jmfriedt/sensor/doc/allocation_regs_modbus.pdf

100+(NB_PICS_MAX*ANTENNES_MAX*2) | A0
..+(NB_PICS_MAX*ANTENNES_MAX*4)
..+(NB_PICS_MAX*ANTENNES_MAX*6) | A2 A1
1000..1000+(NB_PICS_MAX*ANTENNES_MAX*2) | frequences

deviendra *1 quand on stockera temperatures

*2 tant qu’on stocke frequences
