jmfriedt/sensor/doc/interrogateur.pdf

## Algorithme du firmware

C. Droit, 10 mai 2010

## 1 Introduction

Voici un aper¸cu de l’algorithme du firmware

## 2 Explication de la fonction main (Fig. 1)

Le menu pricipal “main” est le corp du programme, il va de l’initialisation `a l’affichage des donn´ees en passant par l’appel des fonctions.
– M1 → Calcul du pas de fr´equence en fonction de Fintsta et Fintsto (Fig. 3)
– M2 → L’interrogation est s´epar´ee en deux parties, une interrogation des capteurs de pression puis des capteurs de temp´erature (interrogation + affichage des donn´ees). Pour avoir un affichage valide de la fr´equence de r´esonance, l’interrogateur doit voir soit tous les capteurs de pression ou tous les capteurs de temp´erature. Dans le cas ou nous activons le mode tracking, si l’interrogateur ne voit plus un capteur de pression, il passe en interrogation peigne fixe sans perturber le mode tracking sur les capteurs de temp´erature.

## 3 Explication fonction balaie ism (Fig. 2)

La fonction balaie ism est la fonction permettant l’interrogation, elle va g´erer l’´emission de fr´equence, la r´eception et le traitement de la mesure, et le calcule de la fr´equence de r´esonance. – B1 → En fonction du mode activ´e mode “tracking” ou “peigne fixe” avec la variable “mode balaye continu”, l’ex´ecution du programme passe par la localisation de la fr´equence de r´esonance une premi´ere foi pour pouvoir calculer la nouvelle fenˆetre d’interrogation qui sera utilis´ee lors du prochain passage dans la fonction. Soit le mode tracking est activ´e et l’ex´ecution passe pas B1 ou nous allons directement `a la partie B5.
– B2 → La boucle de r´ep´etition permet l’accumulation de NBMOY mesure pour calculer la variance et la moyenne des fr´equences de r´esonances trouv´ees.
– B3 → Le traitement de la mesure permet avoir la moyenne des fr´equences de r´esonances trouv´ees et la variance sur ces fr´equences, ce qui permet de juger si la mesure r´ealis´ee est bonne ou fausse.
– B4 → Nous retournons 100 + total si nous avons r´eussi `a avoir NBMOY mesure, la variable “total“ est le nombre d’interrogation effectu´ee. Sinon, nous retournons BSP (le nombre mesure acquise et valide).
– B5 → Si nous avons choisi le mode peigne fixe, nous arrivons directement dans cette partie de la fonction. Sinon si le mode tracking est choisi, nous avons d´eja ´effectu´e le premier balayage qui nous a permit d’ajuster la fenˆetre d’interrogation.
– B6 → En mode tracking, si nous ne trouvons pas la fr´equence de r´esonance dans les points acquis, nous agrandissons la fenˆetre d’interrogation tant que nous n’avons pas la fr´equence de r´esonance. Nous avons ajout´e un d´elai avant de l’agrandir pour ´eviter de sortir trop vite du mode tracking. La fenˆetre d’interrogation ne peut ˆetre plus grande que les fr´equences limites que nous avons rentr´e (Finsta, Finsto). Dans le cas ou nous ne trouvons pas de fr´equence de r´esonance, nous retournons que nous avons pas trouv´e de fr´equence de r´esonance (bsp=0) et une variance de 100000 + le num´ero du r´esonateur l’interrogateur n’a pas trouv´e. Avec une grande variance, nous pouvons ´eliminer la mesure quand nous l’afficherons dans l’interface graphique.

Main

Asservissement de puissance (contrôle de gain)

Initialisation du système DDS + Aduc

Pour chaque antenne

Gestion de la communication +++

Pour tous les capteurs Pression//température

(M1)

(M2)

Appèle de la fonction Balaie_ism

Calcule du pas de fréquence/ Fstart/ Fstop

Balayage_primaire=1;

Activation ou désactivation du mode tracking En fonction de mode_balayage_continu Balayage_primaire=(0/1)

Si la fréquence de résonance trouvée est stable (critère de
Variance), on passe / reste en mode tracking

Ajustement de la fenêtre d'interrogation

Fstart=fréquence de résonance – 1*freq de step Fstop=fréquence de résonance + 1*freq de step

Mode tracking

Sinon on utilise l'ancienne valeur de fréquence Sauvegardée pour délimiter la fenêtre d'interrogation

En peigne fixe
Fstart=finsta du résonateur Fstop=finstop du résonateur

Enregistrement de la fréquence

Affichage des données

Si les critères de seuil sont respectés <Seuil_max
>Seuil_min

Affichage des données

Rs232->
Fréquence/Amplitude/Puissance/Variance

Rs232->
00000000/Amplitude/Puissance/Variance

Pour chaque antenne

Affichage de BSP

Fin

Répétition tant que nb relevé < NB_REPETITION

Figure 1 – Menu principal

Balaie_ism

Mode tracking activé (Balayage primaire==0 && mode_balayage_continu==0)

Scanne de toute la bande ISM

Interrogation de Fstart à Fstop

Emission fréquence par fréquence à une puissance définit pendant Un temps (EMET)

Commutation Emission/Reception

Sauvegarde dans Tab0 des amplitudes reçues

Analyse des données acquises

Recherche des sommets Max

Condition: amplitude
>Seuil_min et <Seuil_max

Calcul de la fréquence de résonance

Fit parabolique: Parab[]=
(Freqres[]+la correction du fit)

Incrémentation variable:
Bsptmp, si pic trouvé
Total: Nb interrogation effectuée

Boucle de répétition tant que Nb résonance Trouvée < NBMOY et le nombre d'inter-Rogation < NBMOY*NBRATE

Mode tracking activé ( premier balayage effectué) ou interrogation peigne fixe (Balayage primaire==1 || mode_balayage_continu==1)

Détection de fréquence de résonance

Si Bsp (nb fréquence de résonance acquise) =
NBMOY( nb fréquence voulu)

Retourne Total+100

Retourne Bsp

Calcul de la moyenne des fréquences de résonance
Calcul de variance des fréquences de résonance | Traitement
Sur la mesure

Retour vers le menu
principal

Scanne en mode 3 points || peigne fixe

Détection de fréquence de résonance

Fenêtre d'interrogation = 3 points par fréquence de résonance

Fréquence de résonance non détecté

Agrandissement de la fenêtre d'interrogation Coefficient de fenêtre incrémenté de 1

Délai d'interrogation de la fenêtre écoulé

On attend avant augmenter la fenêtre d'interrogation, cela permet de faire quelques essaies

Calcul de Fstart et Fstop

Boucle de répétition tant que Nb résonance Trouvées < NBMOY et le nombre d'inter-Rogation < NBMOY*NBRATE

Mode Tracking

Si la fenêtre d'interrogation dépasse
Fstart et Fstop peigne fixe, on rescanne
Toute la bande ISM (balayage_primaire=0)

Retroune bsp=0 et une variance de 100000 + le numéro du résonateur non trouvé

Mode Tracking

Traitement de la mesure

Retour vers mesure principale

Lo

c

alisation des fréquenc

es de résonanc

es m

ode tra

cking par peigne fix

e

M

o

d

e tra

cking

&

m

o

d

e

b

a

al ya

g

e

p

eigne fix

e

F

onction b

alaie

_ism

Les variables NBMOY et NBRATE
Sont configurable dans DDS.h elles correspondent au nombre de moyenne et d'itération à effectuer avant de quitter l'interrogation et d'afficher la valeur de la fréquence de résonance trouvée

(B1)

(B2)

(B4)

(B5)

(B6)

(B6) (B2)

(B3)

Figure 2 – Fonction Balaie ism

## 4 Taux de rafraˆıchissement

Interrogation de 2 r´esonateurs :
– Mode tracking, NBMOY=16 Taux de rafraˆıchissement max = 45 Hz – Mode tracking, NBMOY=1 Taux de rafraˆıchissement max = 90 Hz – Mode peigne fixe, NBMOY=16 Taux de rafraˆıchissement = 45 Hz – Mode peigne fixe, NBMOY=1 Taux de rafraˆıchissement = 5 Hz Interrogation de 3 r´esonateurs :
– Mode tracking, NBMOY=16 Taux de rafraˆıchissement max = 32 Hz – Mode peigne fixe, NBMOY=16 Taux de rafraˆıchissement = 3 Hz

## 5 Configuration du fichier DDS.h (Fig. 3)

Dans le fichier de configuration ”DDS.h“, nous pouvons configurer plusieurs param`etres : – L’offset : OFFSET 0xDDD0000
– Mode de debuggage qui permet de voir le d´eroulement du programme define debug
– Controle automatique de puissance agc=1 ;
– Nombre de moyenne NBMOY=16 ;
– Nombre de r´esonateur NBPICS=2 ;
– Nombre de pas par bande NBSTEPS=(64)
– Nombre d’antenne ANTENNES=1 ;
– Mode tacking/peigne fixe mode balayage continu=1 ;
– Nombre de r´esonateur d’une grandeur physique PRESSION
– Nombre de r´esonateur de l’autre grandeur physique TEMPERATURE
– Nombre de r ´ep´etition de la mesure de la premi´ere grandeur NB REPETITION
– Borne de fr´equence de start Fintsta[NBPICS MAX]=0x28F5C200, 0x2CCCCC00, 0x2E147AE0; – Borne de fr´equence de stop Fintsto[NBPICS MAX]=0x2CAC0800, 0x2E147AE0, 0x2F5C2800; Pour avoir un mesure valide, nous devons voir tous les capteurs de la grandeur PRESSION
ou tout les capteurs de la grandeur TEMPERATURE. La somme de (PRESSION + TEM-PERATURE)=( NB PIC MAX )=(NB PIC). Si nous avons un capteur de temperature constitu´e de 2 r´esonateurs avec un capteur de pression constitu´e d’un r´esonateur, on a PRES-SION = 1, TEMPERATURE = 2, NB PIC=3, NB PIC MAX =3.

## 6 D´ebuggage et affichage des donn´ees

Pour ´eliminer les fr´equences erron´ees, nous pouvons filtrer :
– Avec une hauteur Max/min d’amplitude d´etect´ee
– Avec une variance faible, si la variance est ´elev´ee, c’est que nous avons des perturbations. Si elle est de 100000, 100001... Nous n’avons pas r´eussi `a trouver le r´esonateur 1,2... en mode tracking.
– Le nombre BSP correspond au nombre de valeur trouv´ee si il est < `a NBMOY sinon il correspond au nombre d’interrogation total r´ealis´e quand nous avons r´eussi `a avoir NBMOY fr´equence de r´esonance.


Figure 3 – DDS.h
