jmfriedt/sensor/doc/131206timing_gillouxV1_HATTENTE.png

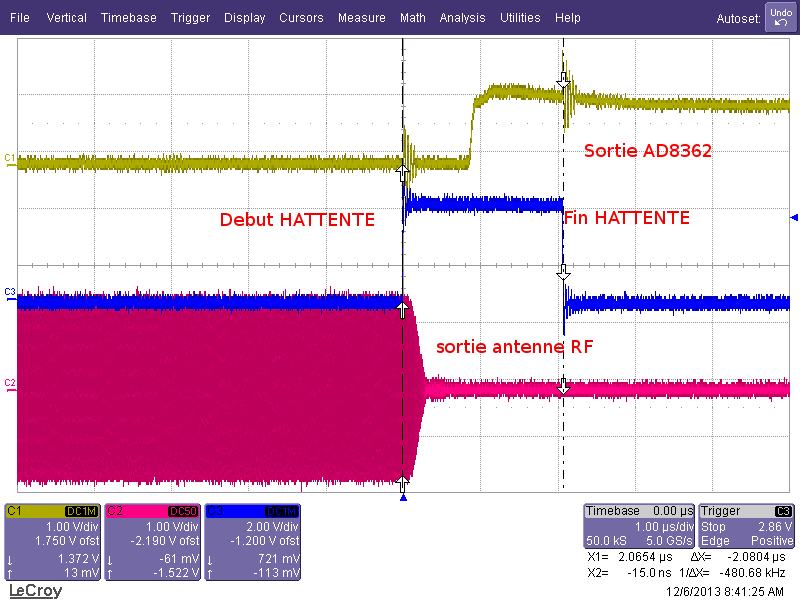
doc/131206timing_gillouxV1_HATTENTE.png
