jmfriedt/sensor/doc/131206timing_gillouxV1_HATTENTEx5.png

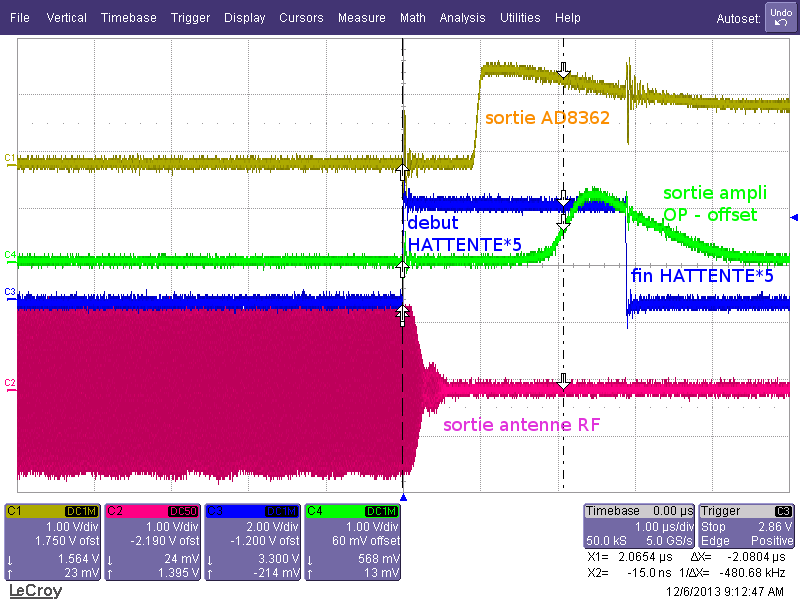
doc/131206timing_gillouxV1_HATTENTEx5.png
