jmfriedt/sensor/doc/AD8302_20dBmag.png

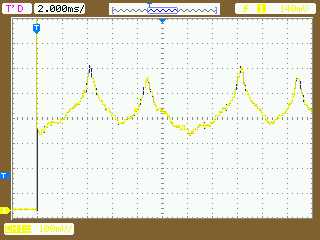
doc/AD8302_20dBmag.png
