jmfriedt/sensor/doc/AD8302_20dBpha.png

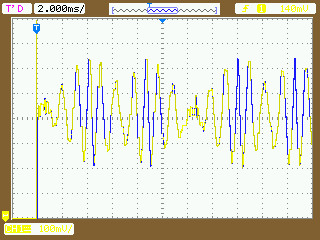
doc/AD8302_20dBpha.png
