jmfriedt/sensor/doc/AD8302_30dBmag.png

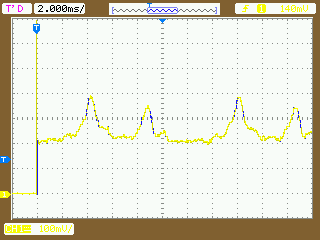
doc/AD8302_30dBmag.png
