jmfriedt/sensor/pictures/IMG_0642.JPG

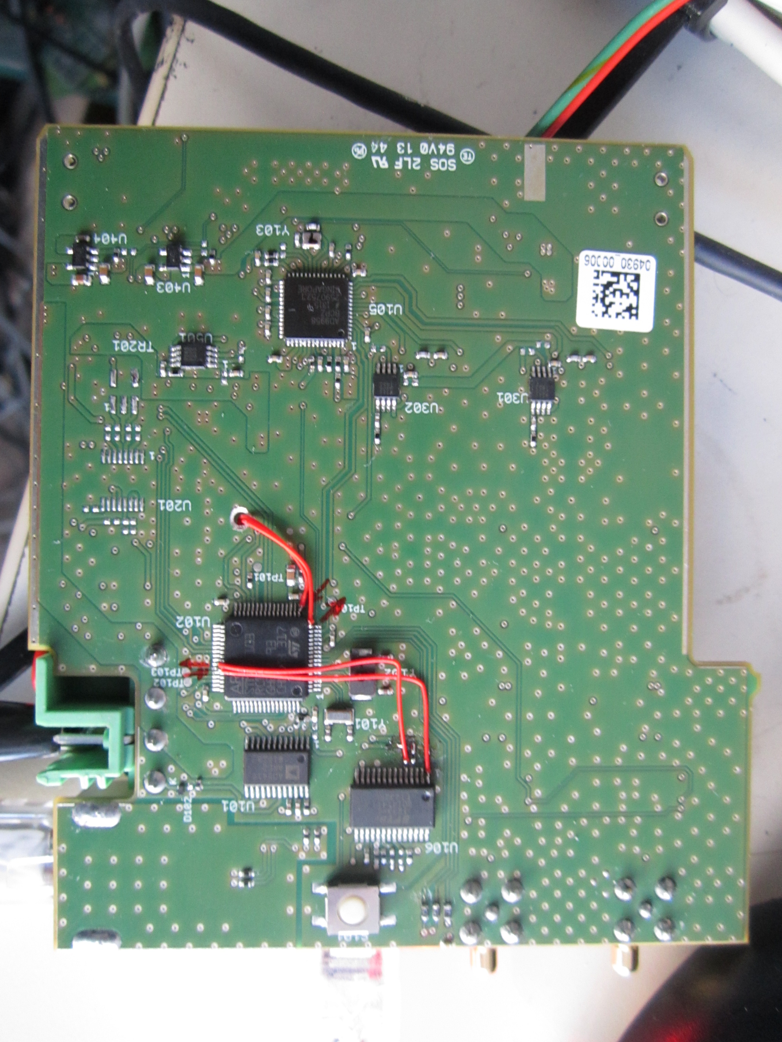
pictures/IMG_0642.JPG
