jmfriedt/sensor/pictures/IMG_0643.JPG

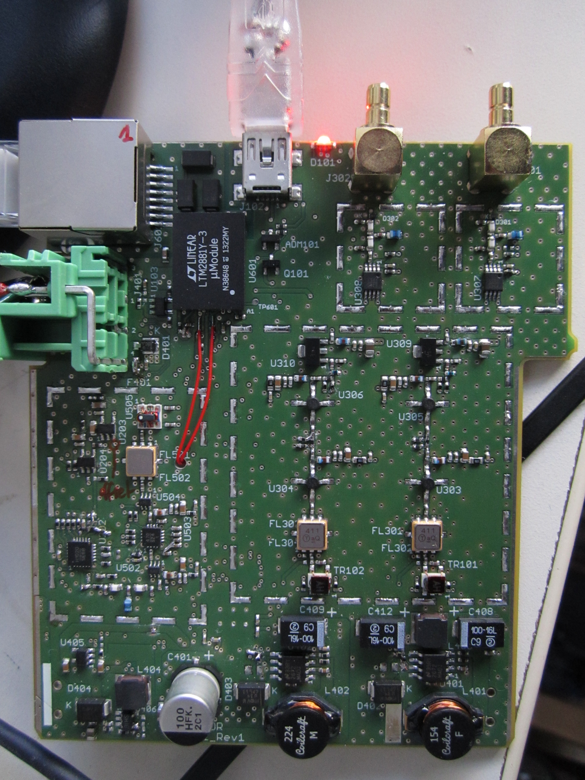
pictures/IMG_0643.JPG
