jmfriedt/sensor/doc/Cadstar_-_PC015-SCH-01-B.pdf

# DDS+VCO

# POWER SUPPLY

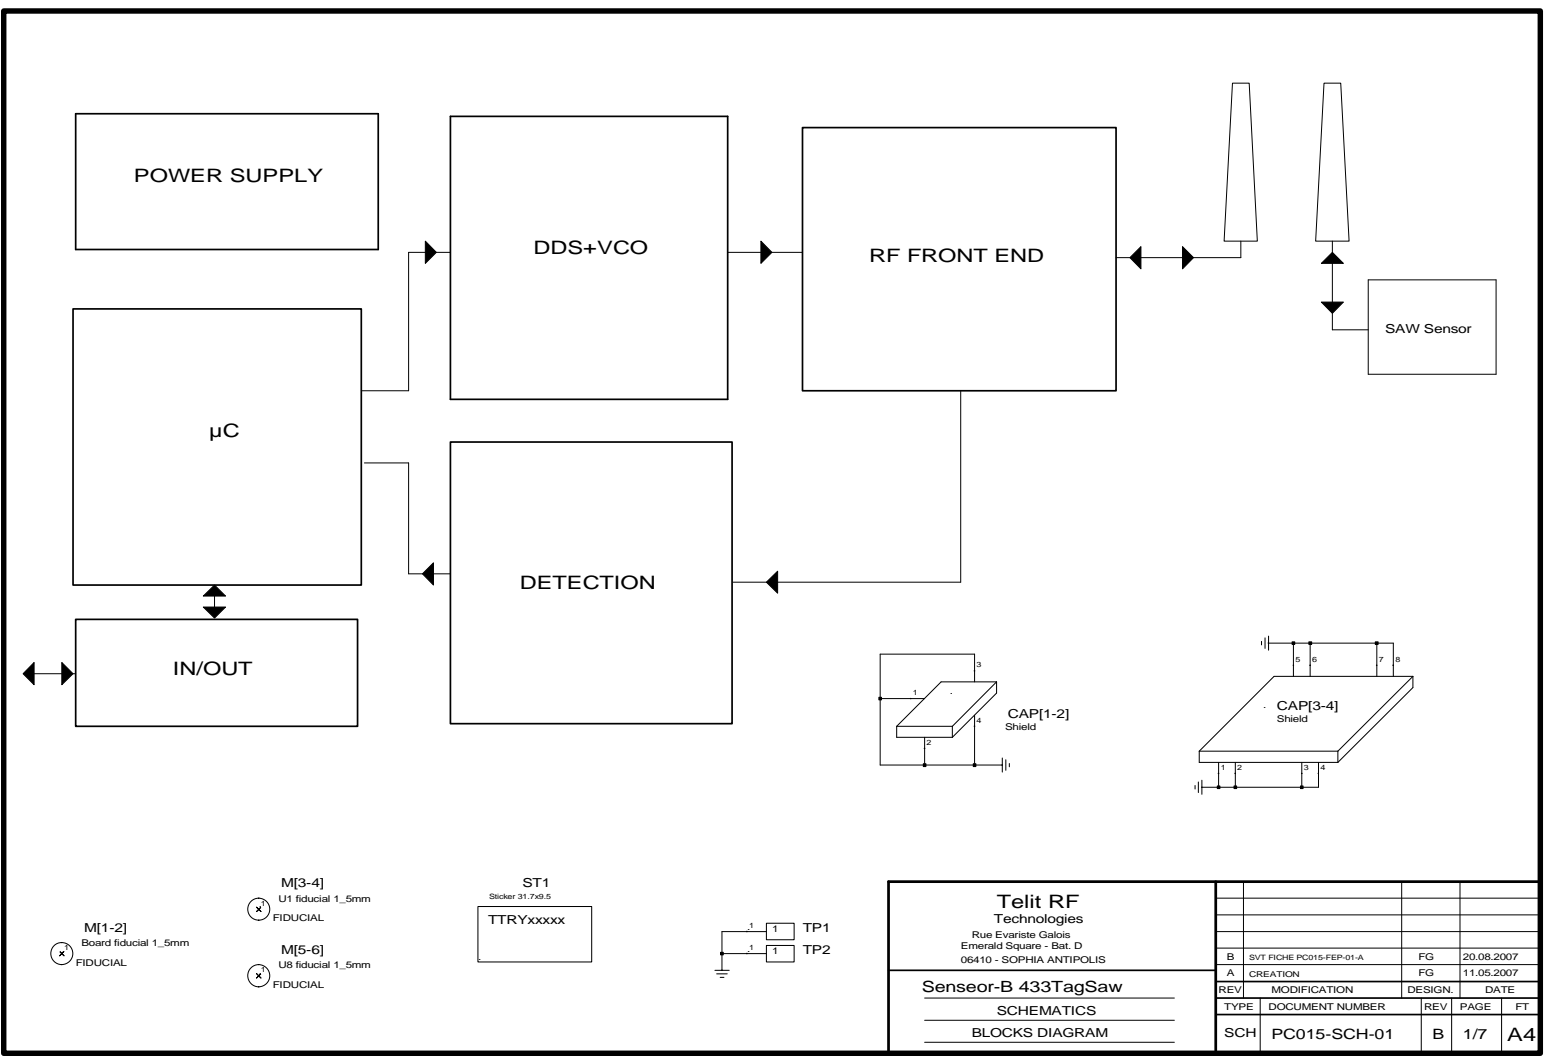
[picture p9: page 1]
IN/OUT; DETECTION; FIDUCIAL; U1 fiducial 1_5mm; U8 fiducial 1_5mm; Board fiducial 1_5mm; TTRYxxxxx; Sticker 31.7x9.5; CAP[1-2]; Shield; CAP[3-4] . Shield; PAGE; DESIGN.; TYPE; DOCUMENT NUMBER; DATE; REV; MODIFICATION; CREATION; BLOCKS DIAGRAM; SCH; PC015-SCH-01; SCHEMATICS; FG SVT FICHE PC015-FEP-01-A; SAW Sensor

RF FRONT END

Telit RF
Technologies
Rue Evariste Galois
Emerald Square - Bat. D
06410 - SOPHIA ANTIPOLIS
Senseor-B 433TagSaw

## I/O_Update

## CS#_DDS

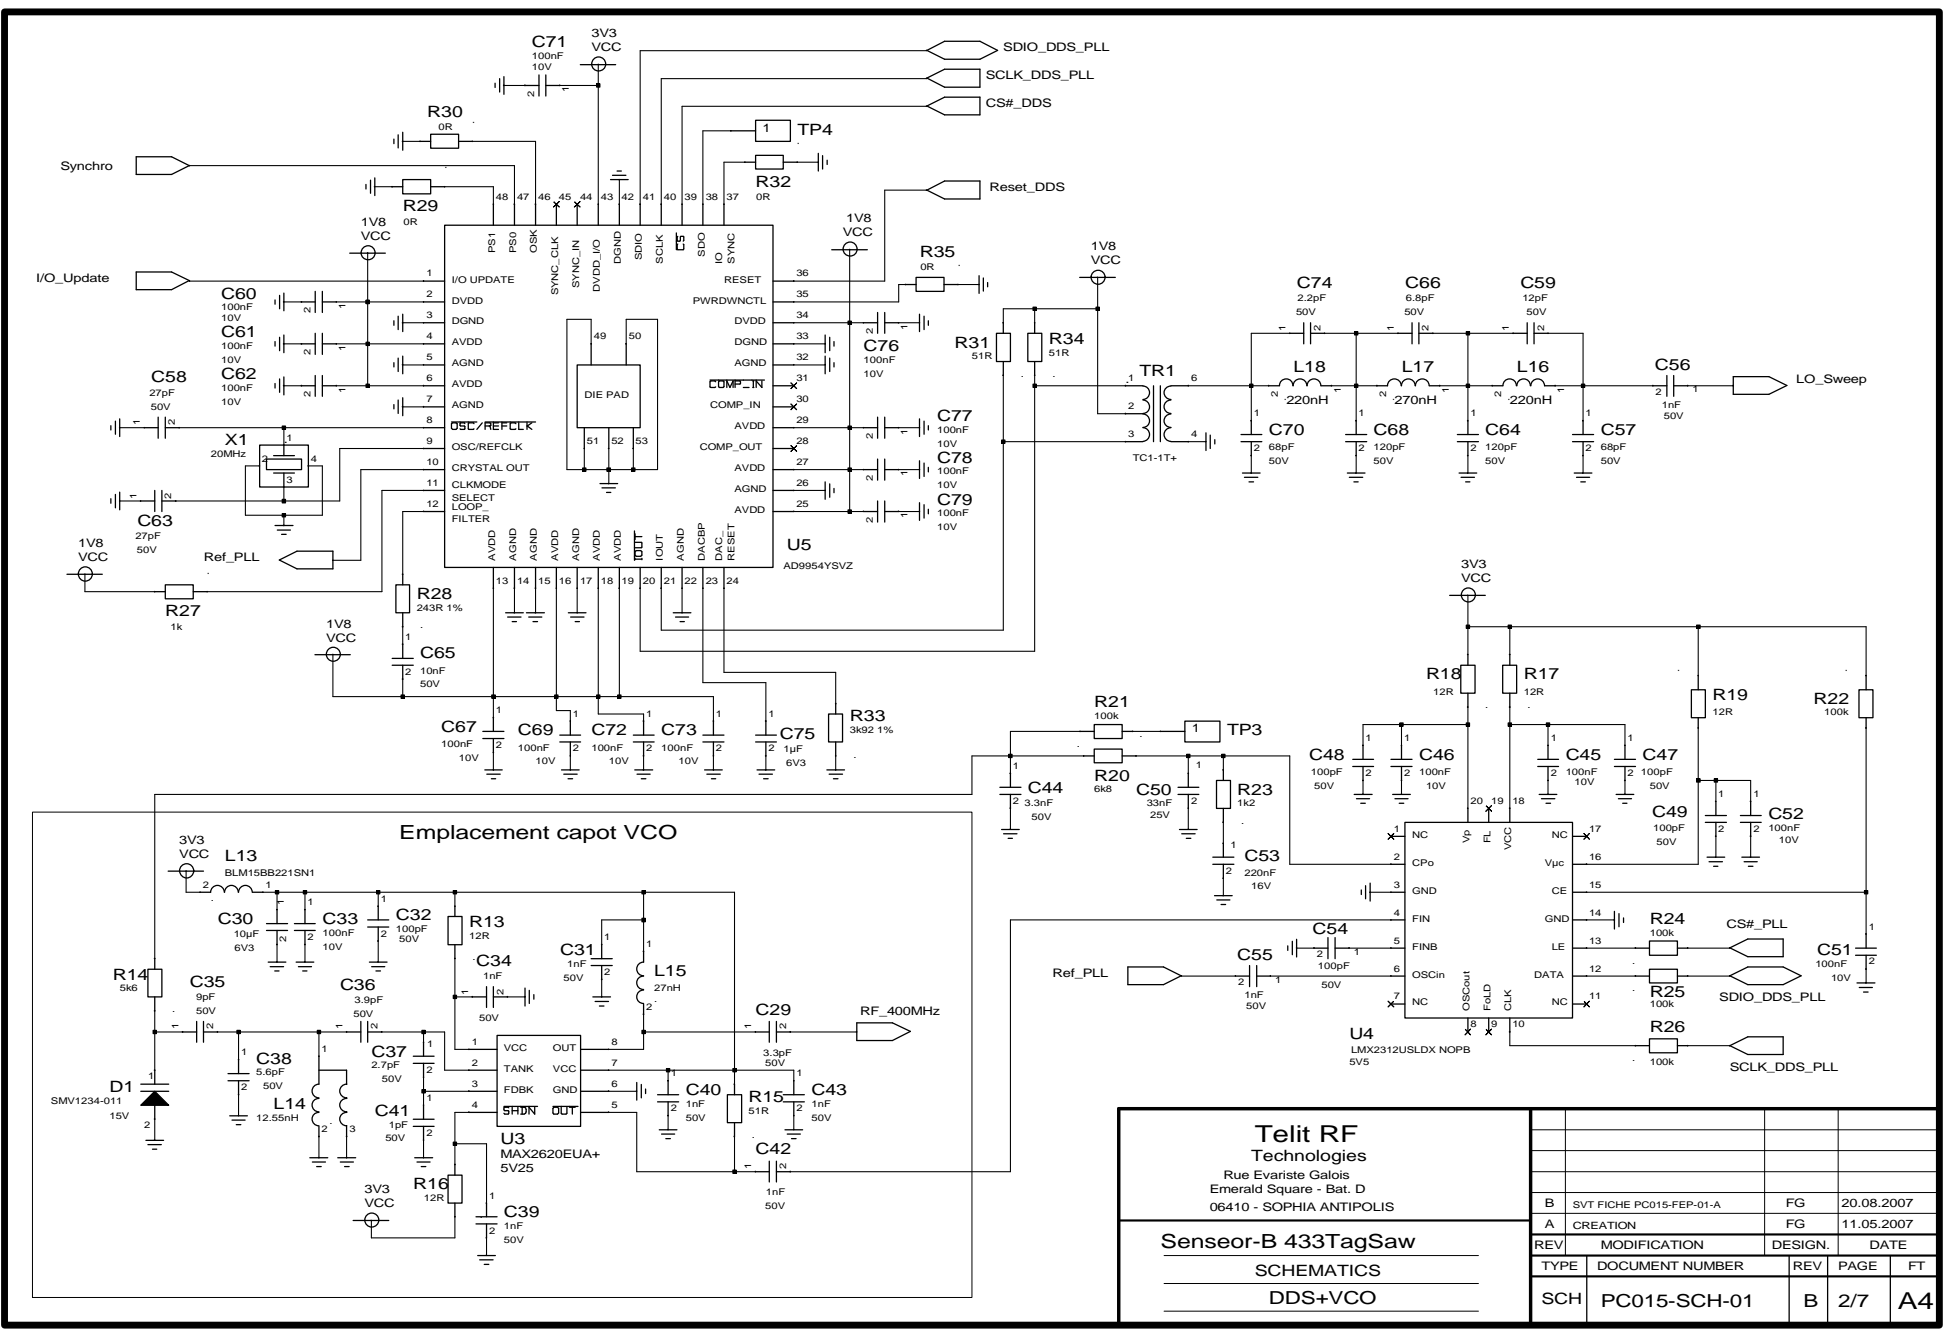
[picture p10: page 2]

VCC CLK NC Vµc FINB FIN

+5V

## VCC

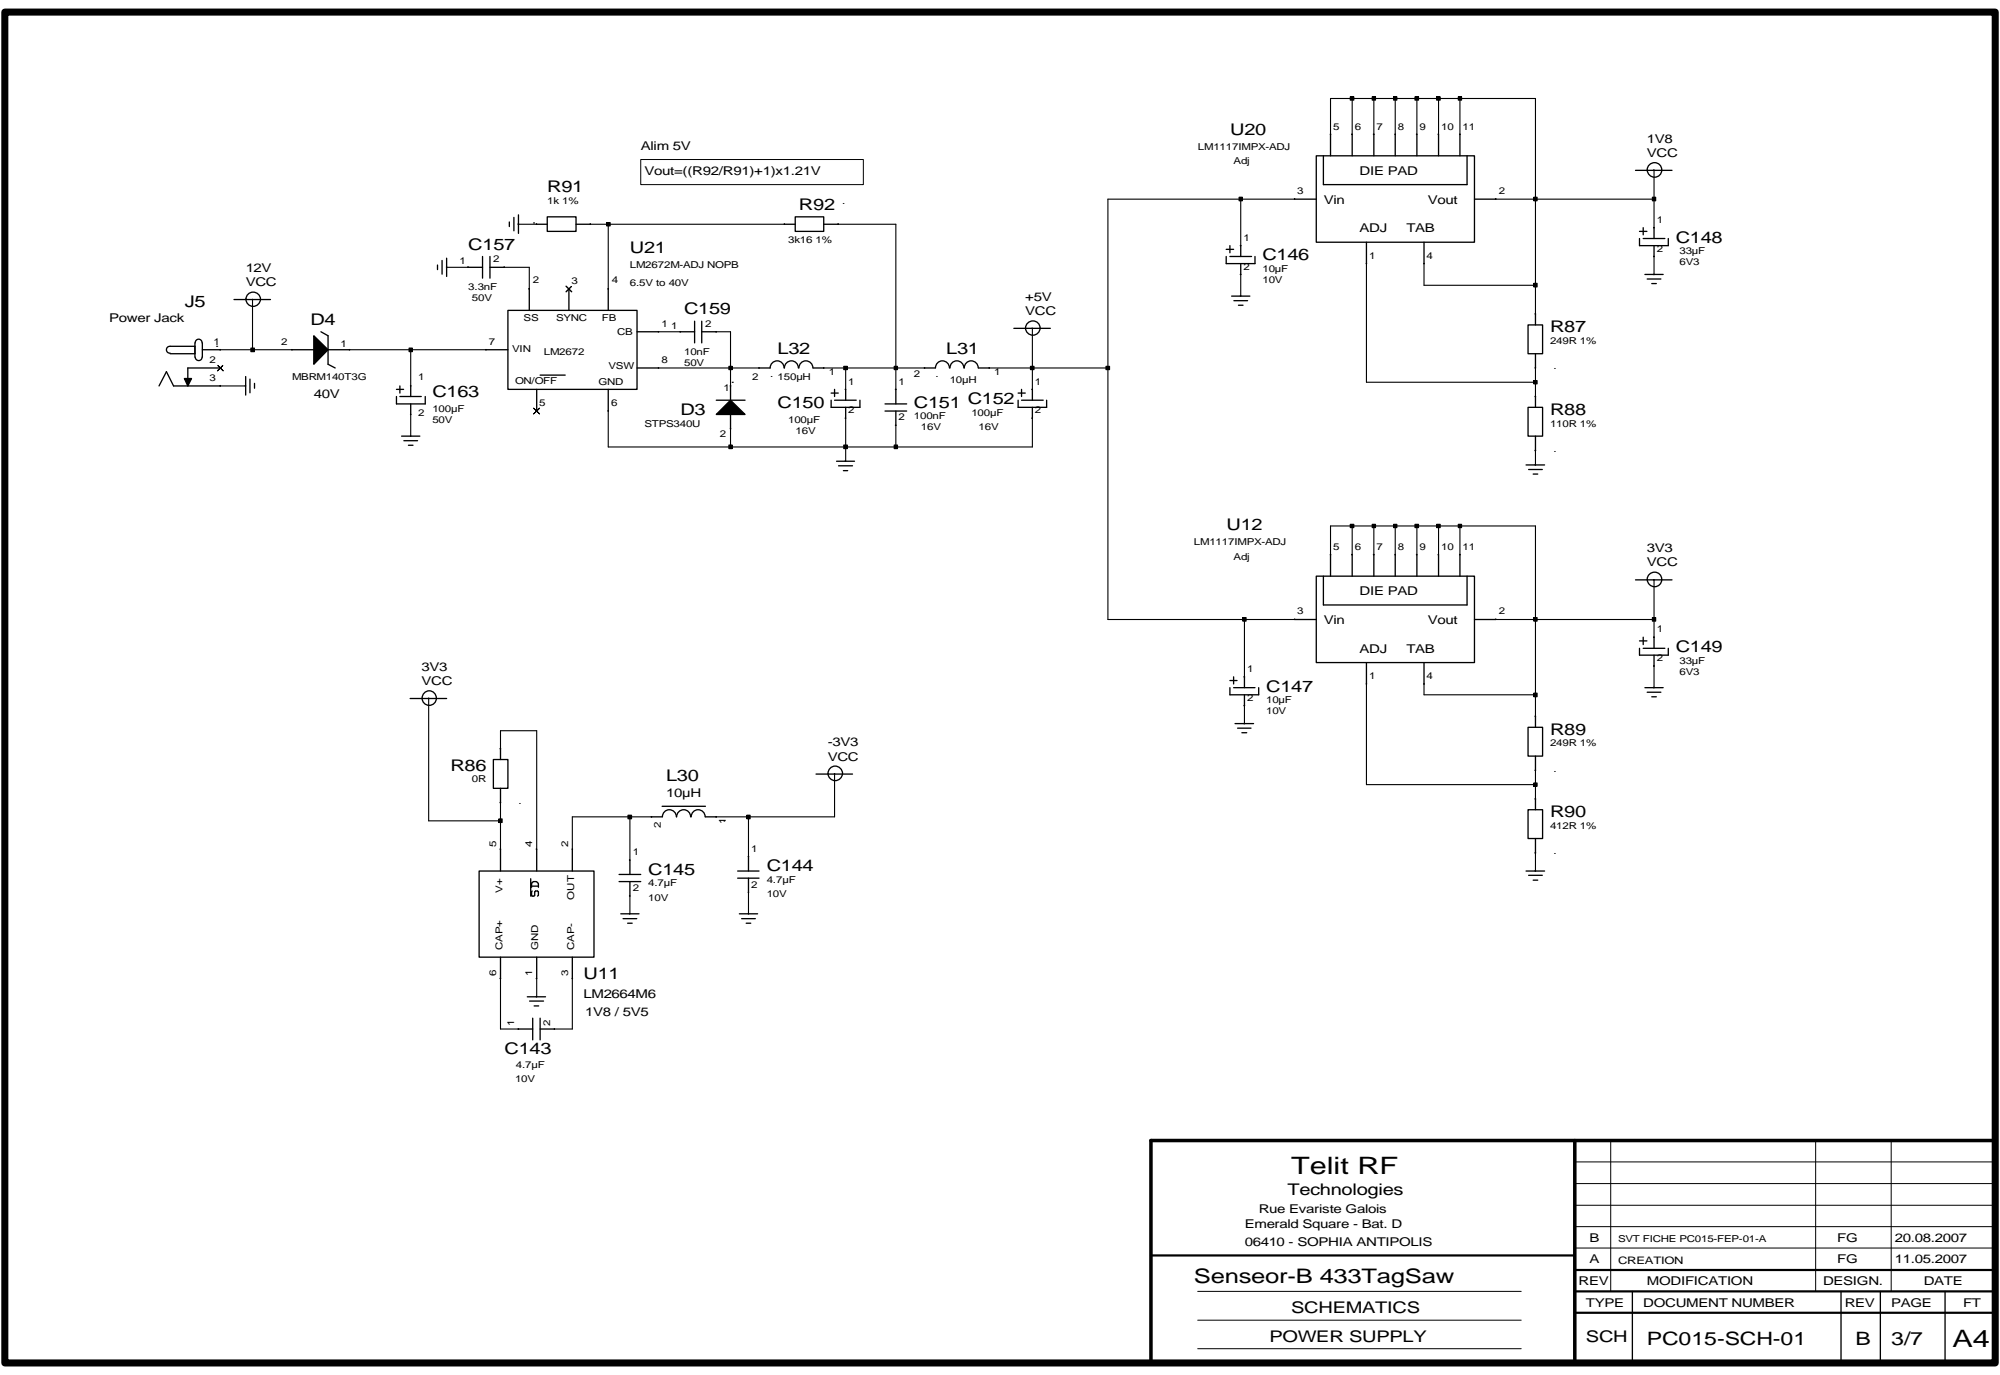
[picture p11: page 3]

## RF_400MHz

## LO_Sweep

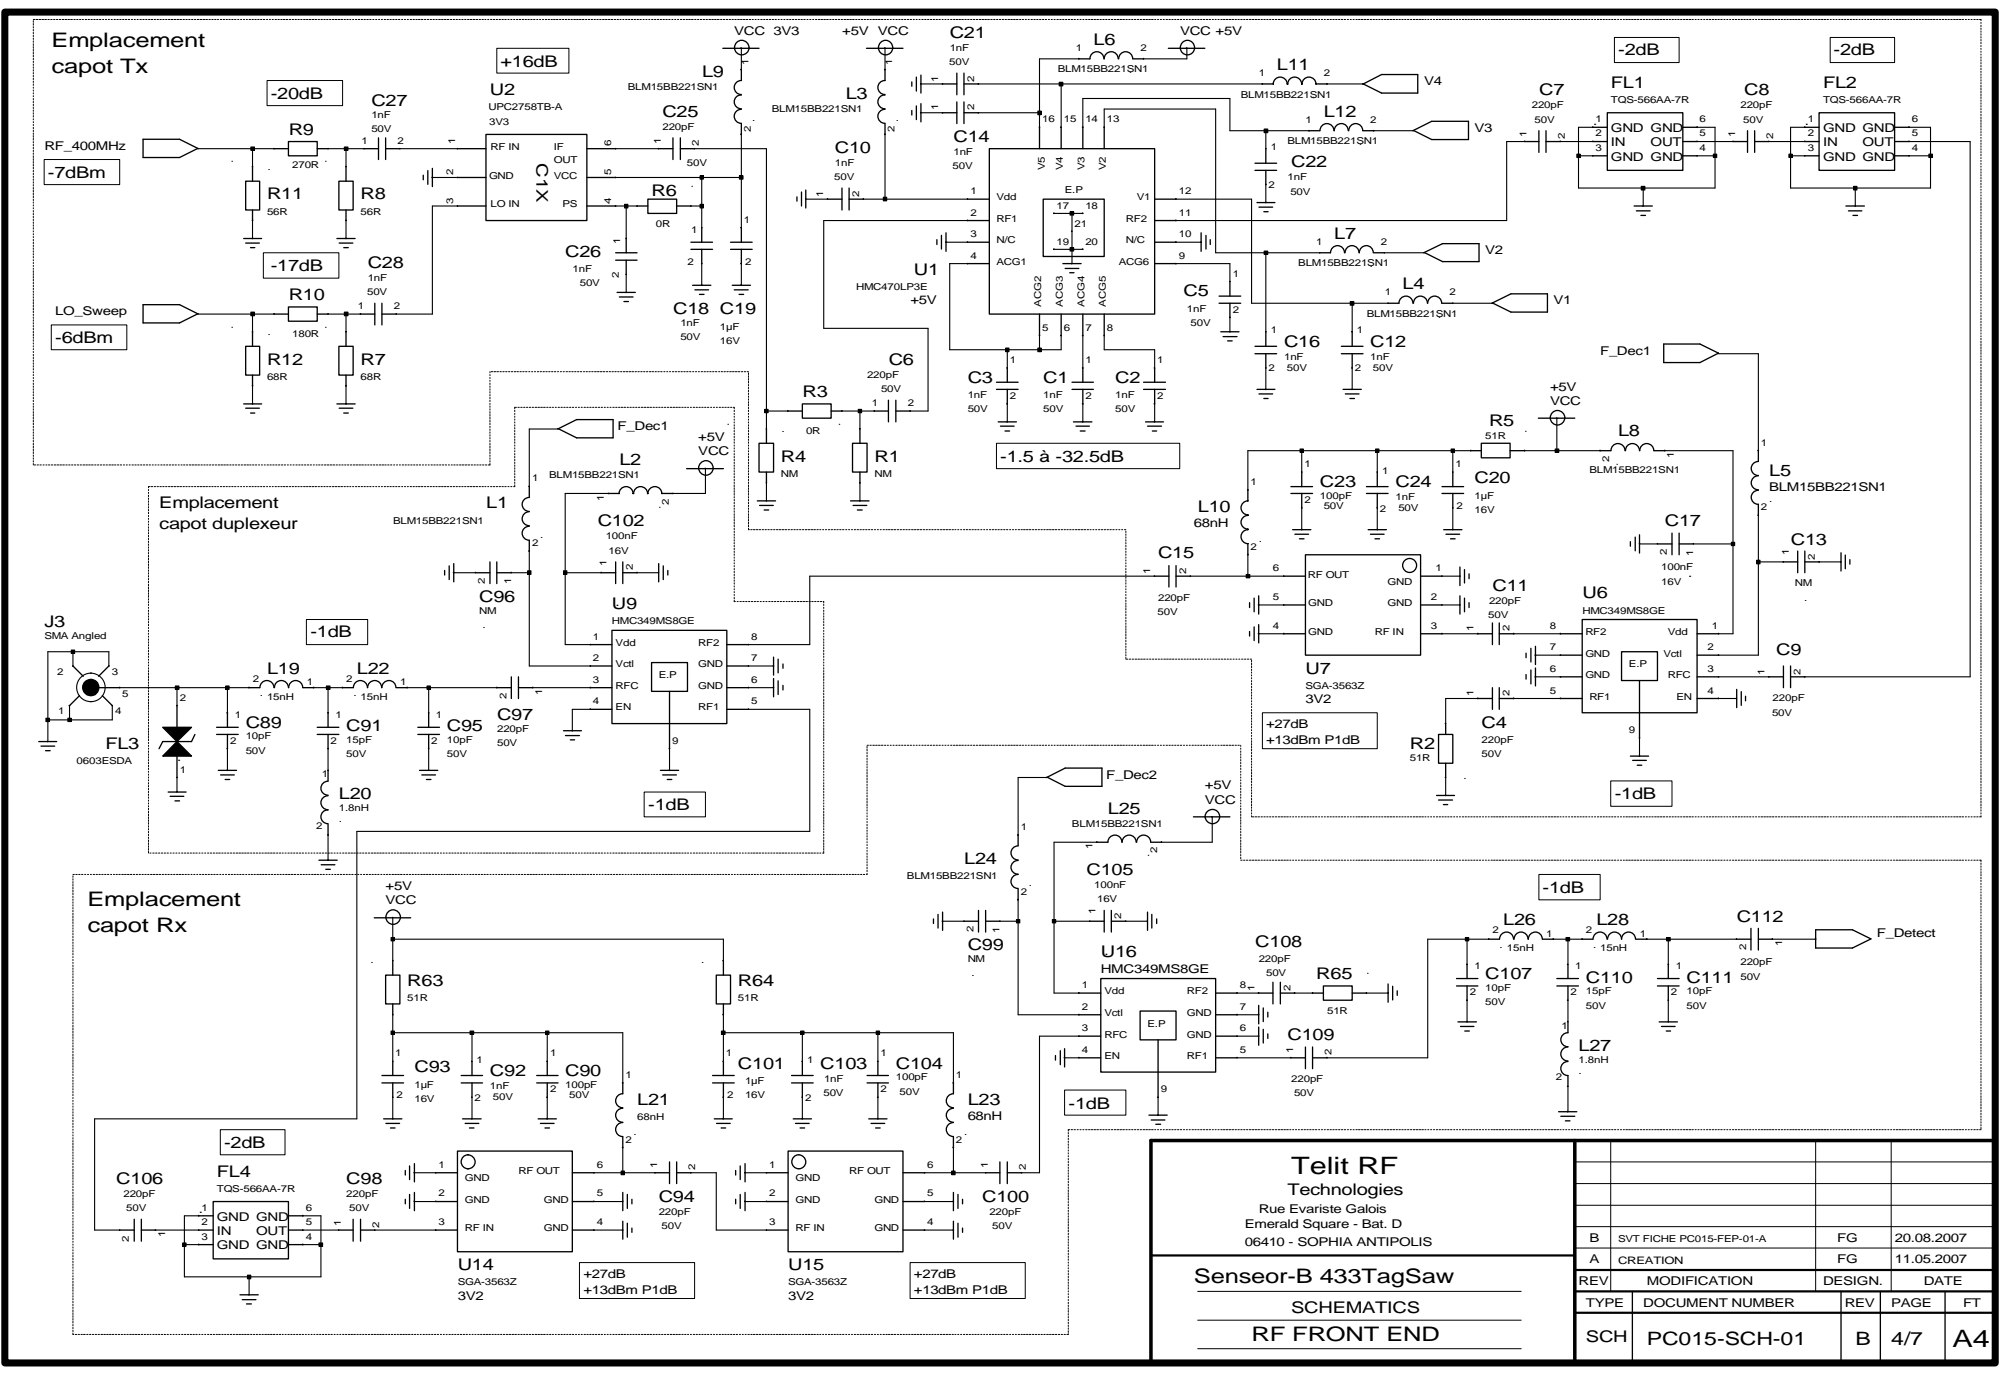
[picture p12: page 4]

## CS#_PLL_µC

## RxD

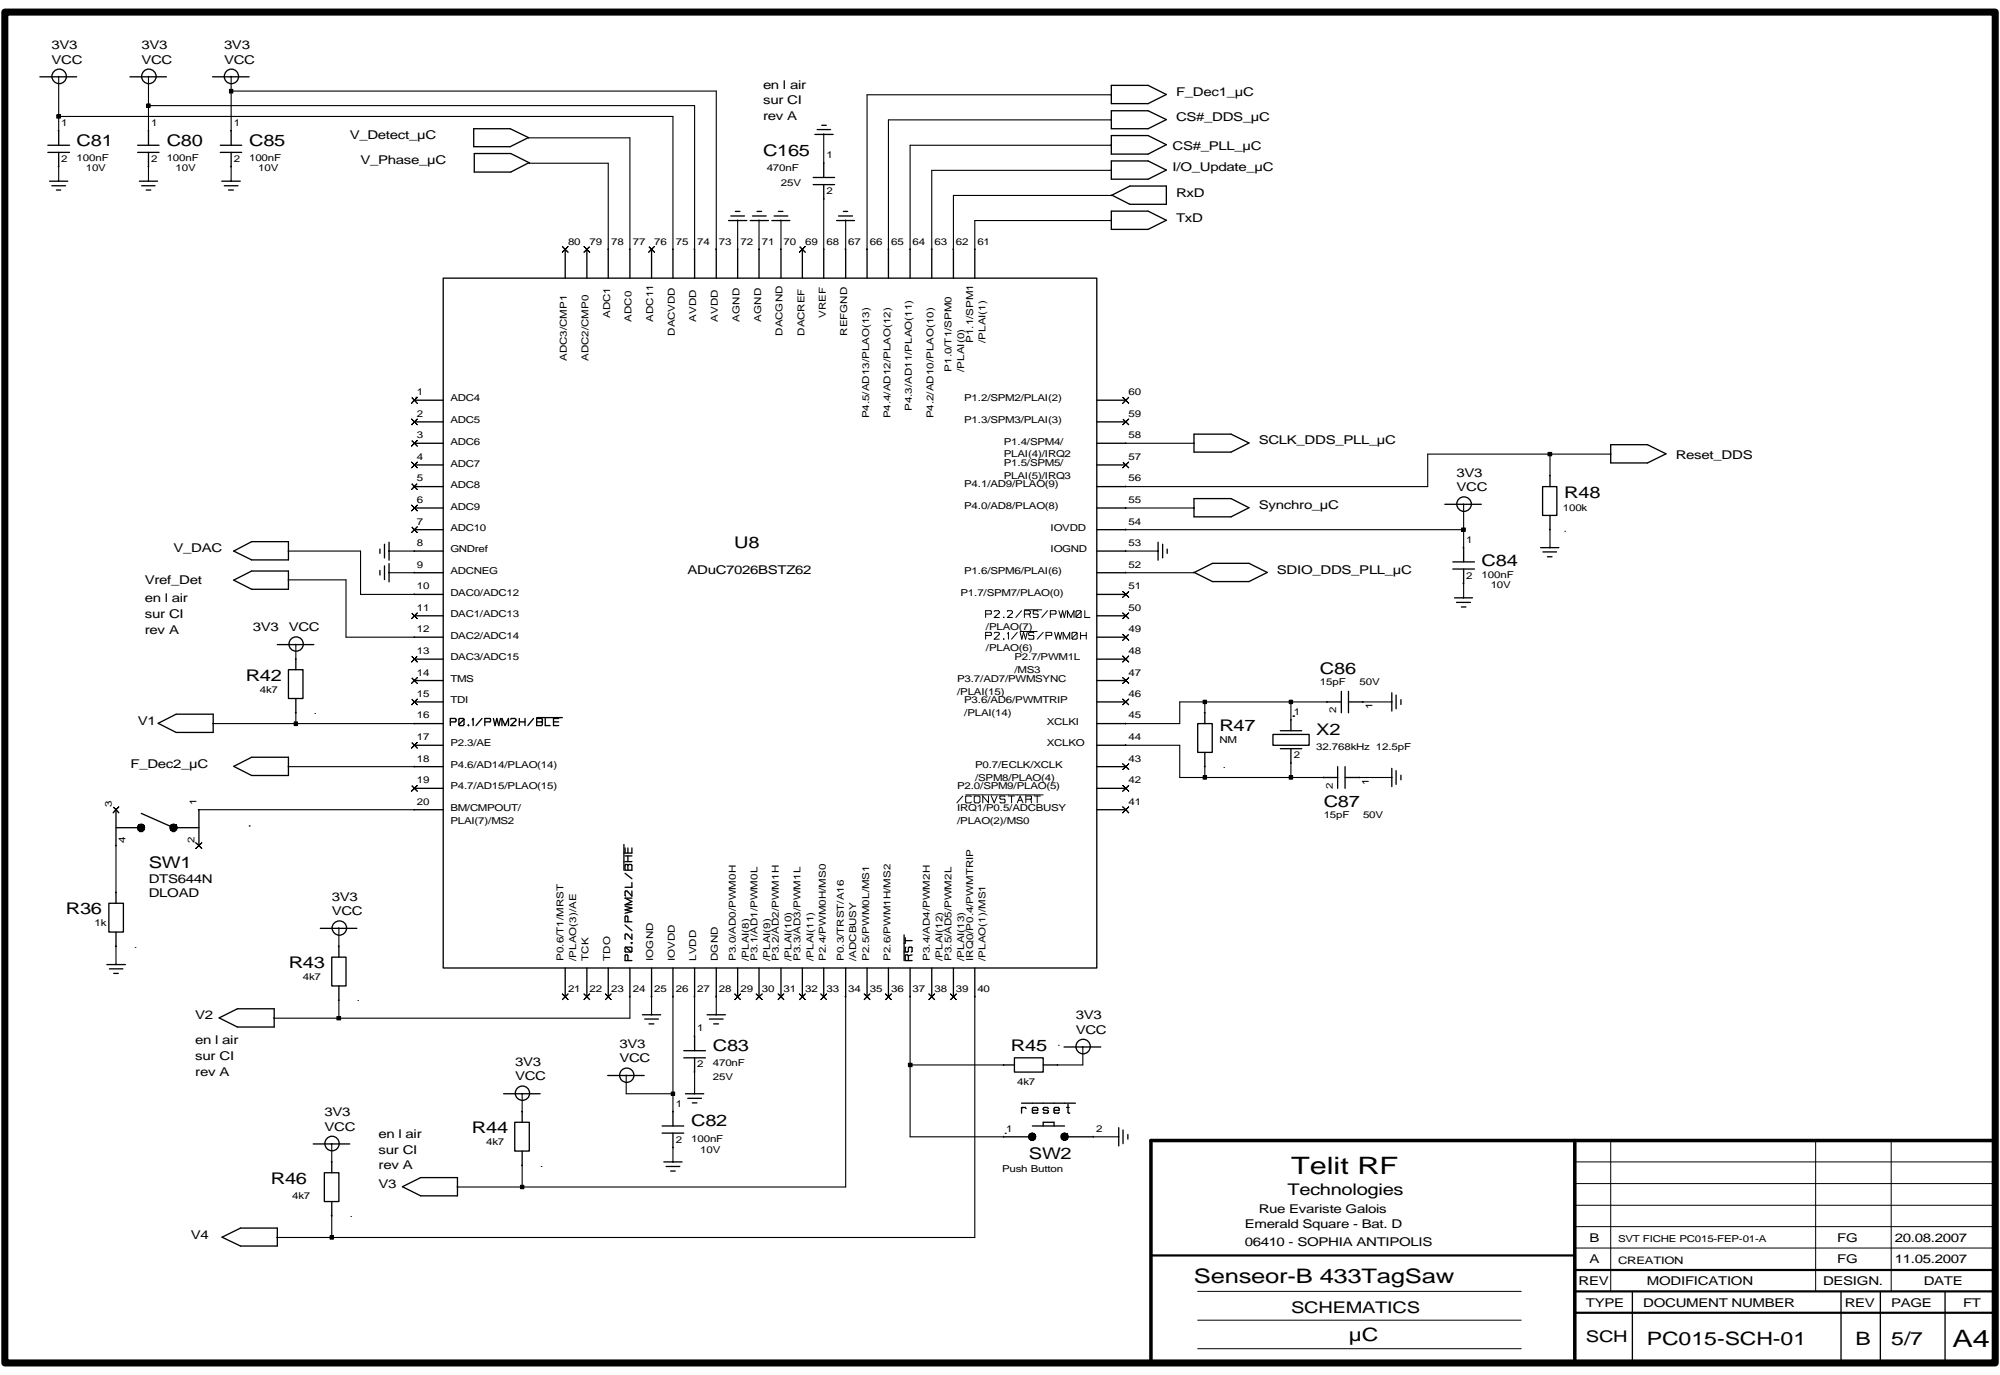
[picture p13: page 5]

## Vref_Det

3V3

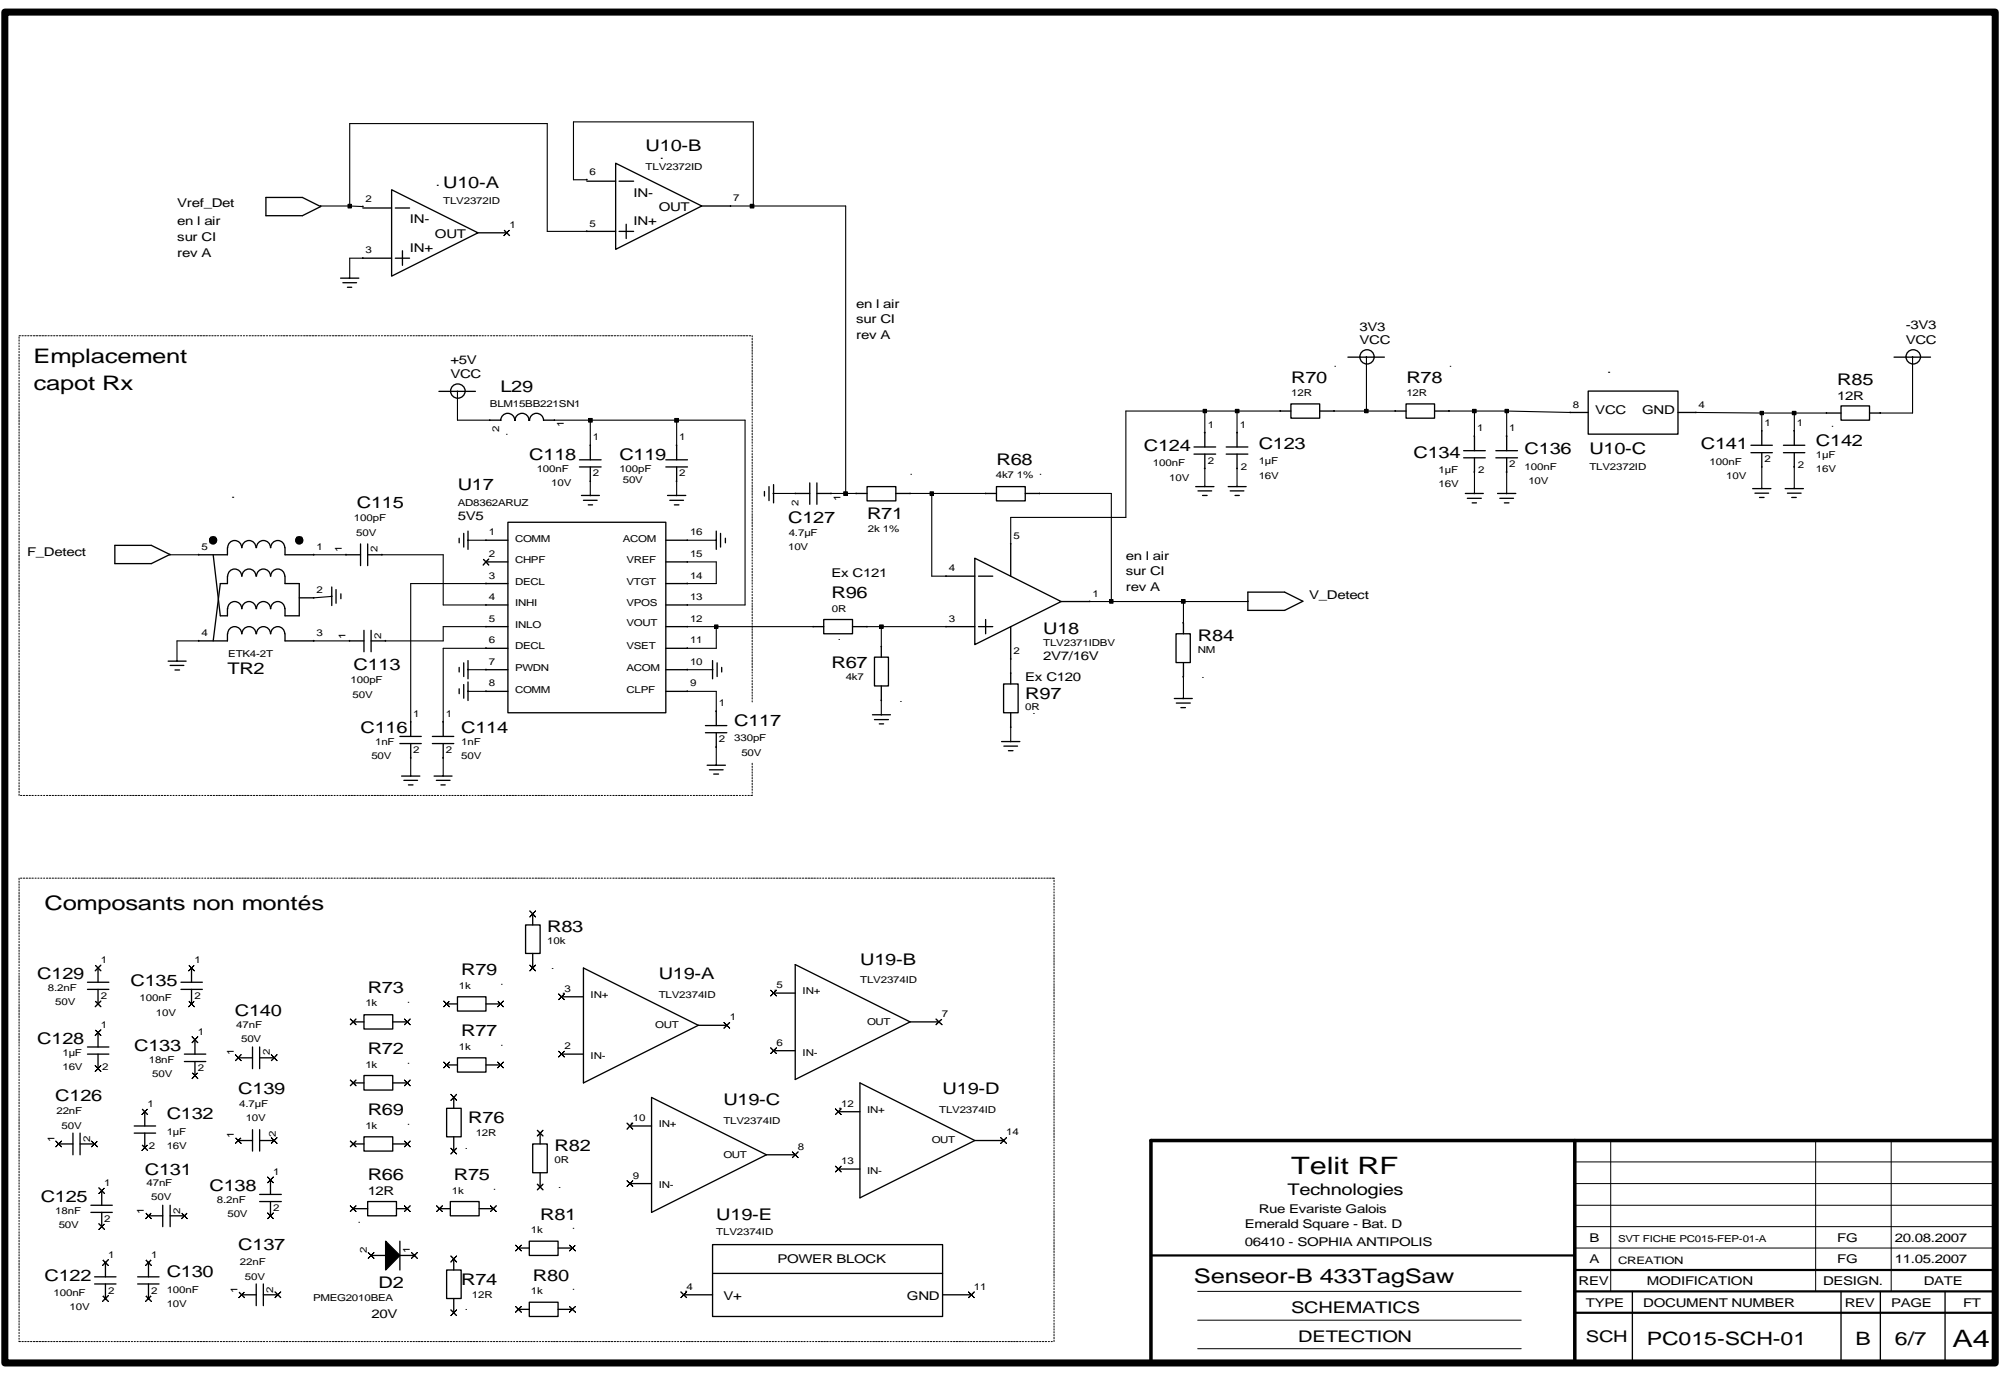
[picture p14: page 6]

## TxD RxD

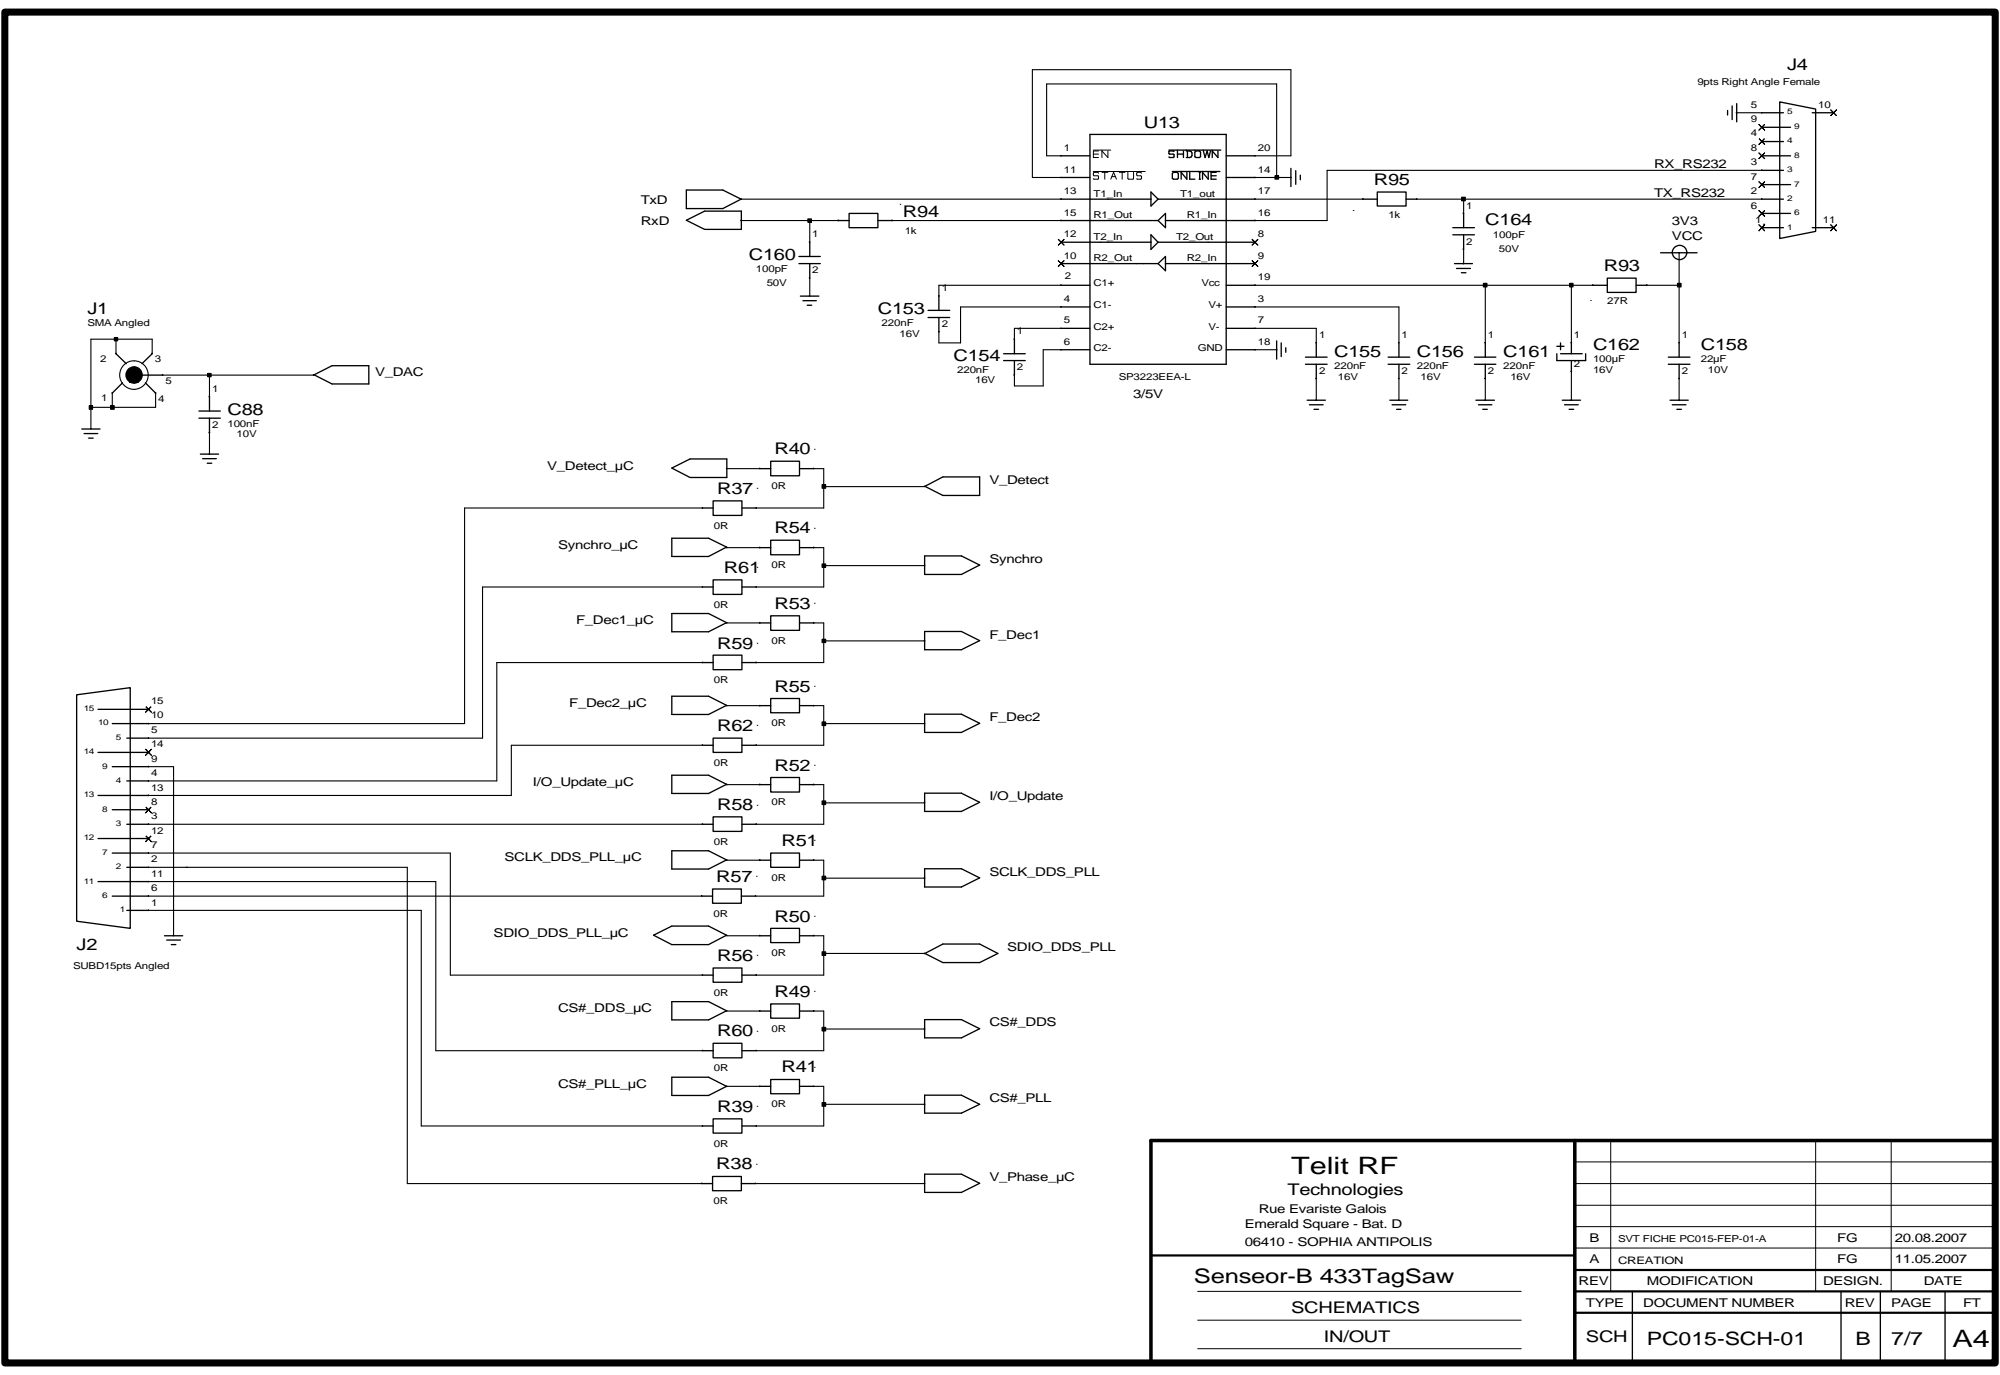
[picture p15: page 7]
