jmfriedt/sensor/mesures/moyfit_fitmoy_temps.pdf

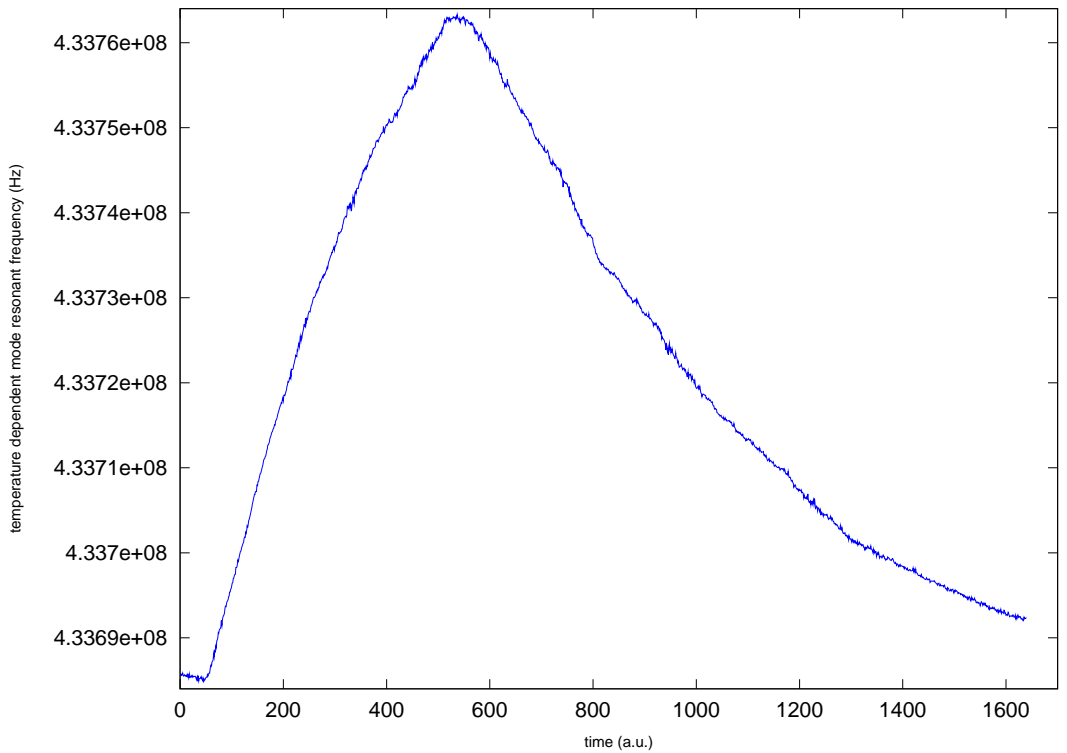
[picture p16: page 1]
time (a.u.)

temperature dependent mode resonant frequency (Hz)
