jmfriedt/sensor/mesures/moyennefit_fitmoyenne.pdf

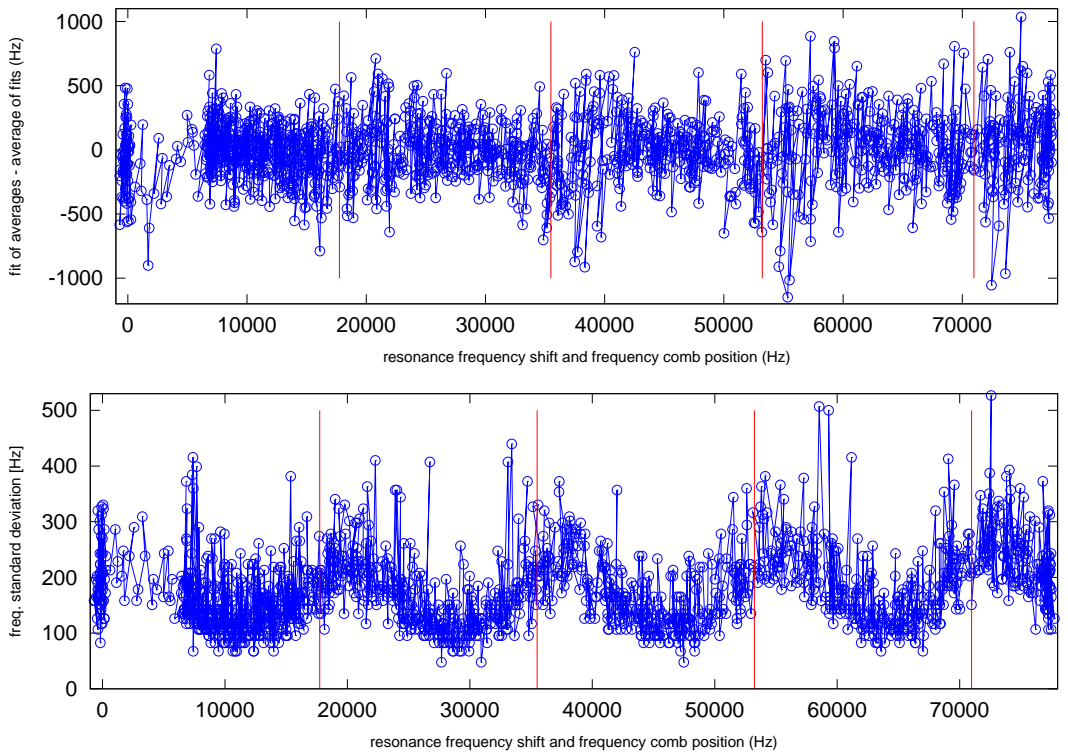
[picture p17: page 1]

fit of averages - average of fits (Hz)

resonance frequency shift and frequency comb position (Hz)

freq. standard deviation [Hz]
