jmfriedt/sensor/doc/new_sawtag_2012.brd

## EAGLE design doc/new_sawtag_2012.brd (2022-07-16)

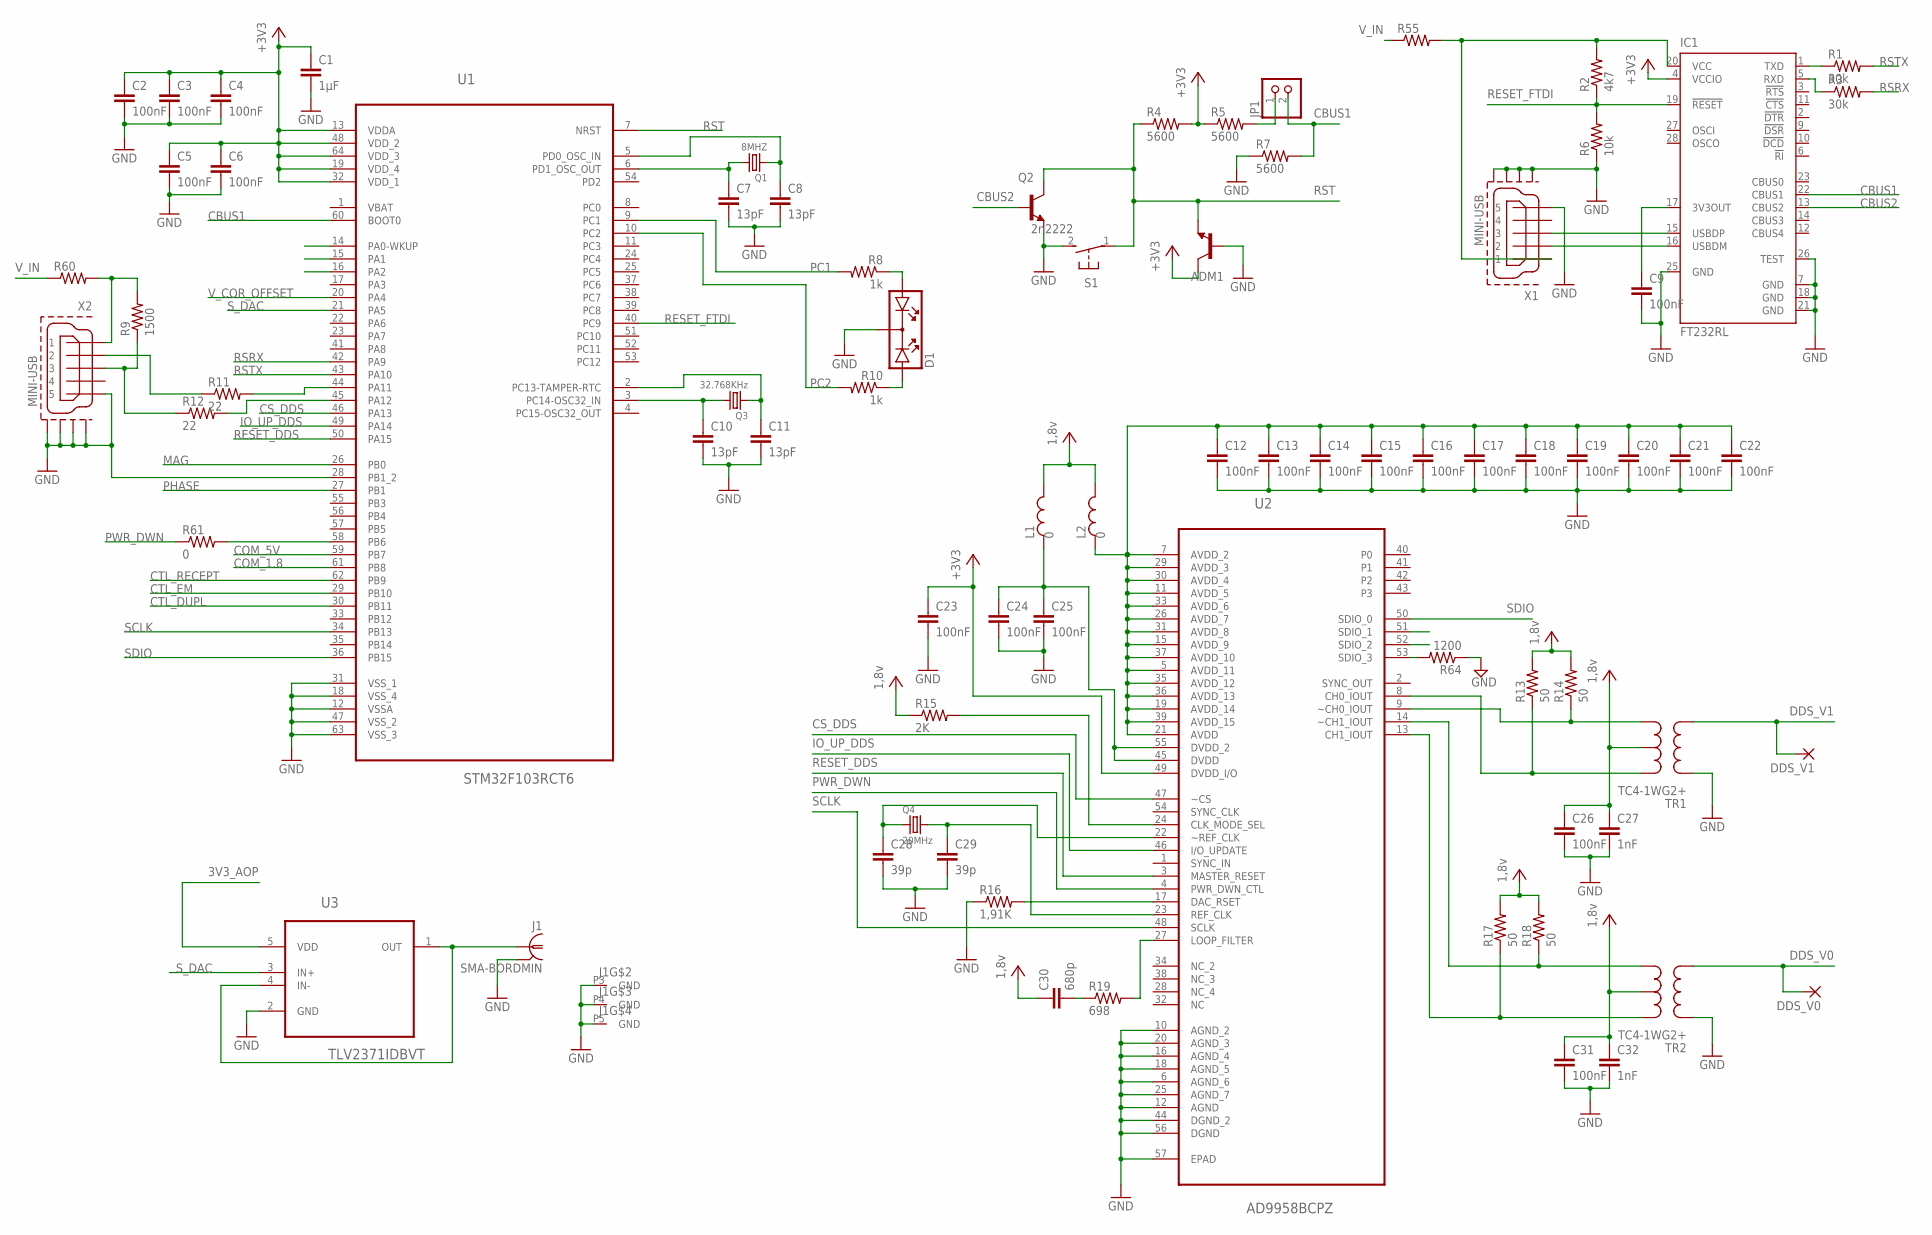
[picture p18: schematic new_sawtag_2012.sch, sheet 1]

Parts:
ADM1: TRANSISTOR_NPNSOT23; SOT23
C1: 1µF; C0805
C2, C3, C4, C5, C6, C9, C23, C24, C25, C26, C31: 100nF; C0603
C7, C8, C10, C11: 13pF; C0603
C12, C13, C14, C15, C16, C17, C18, C19, C20, C21, C22: 100nF; C0402
C27, C32: 1nF; C0402
C28, C29: 39p; C0402
C30: 680p; C0402
D1: DUOLED
DDS_V0, DDS_V1: 1,6/0,8
IC1: FT232RL; SSOP28
J1: SMA-BORDMIN; SMA_BORDMIN
JP1: PINHD-1X2; 1X02
L1, L2: 0; 0603
Q1: 8MHZ; SMD_5*3
Q2: 2n2222; SOT23
Q3: 32.768KHz; SMD_32K
Q4: 20MHz; SMD_5*3
R1, R3: 30k; R0402
R2: 4k7; R0402
R4, R5, R7: 5600; R0603
R6: 10k; R0402
R8, R10: 1k; R0603
R9: 1500; R1206
R11, R12: 22; R0603
R13, R14, R17, R18: 50; R0402
R15: 2K; R0402
R16: 1,91K; R0402
R19: 698; R0402
R55, R60: R-US_R2512; R2512
R61: 0; R0603
R64: 1200; R0402
S1: 31-XX; B3F-31XX
TR1, TR2: TC4-1WG2+; AT224-3
U1: STM32F103RCT6; QFP50P1200X1200X160-64N
U2: AD9958BCPZ; QFN50P800X800X100-57N
U3: TLV2371IDBVT; SOT95P280X145-5N
X1, X2: MINI-USB; UX60-MB-5ST

Connections:
3V3_AOP: U3.5 (VDD); also elsewhere on the board
+3V3: ADM1.3 (C), C1.1, C2.1, C3.1, C4.1, C5.1, C6.1, C23.1, IC1.4 (VCCIO), R4.2, R5.1, U1.13 (VDDA), U1.19 (VDD_4), U1.32 (VDD_1), U1.48 (VDD_2), U1.64 (VDD_3), U2.49 (DVDD_I/O); also elsewhere on the board
ALDDS: C12.1, C13.1, C14.1, C15.1, C16.1, C17.1, C18.1, C19.1, C20.1, C21.1, C22.1, L2.1, U2.5 (AVDD_11), U2.7 (AVDD_2), U2.11 (AVDD_5), U2.15 (AVDD_9), U2.19 (AVDD_14), U2.21 (AVDD), U2.26 (AVDD_7), U2.29 (AVDD_3), U2.30 (AVDD_4), U2.31 (AVDD_8), U2.33 (AVDD_6), U2.35 (AVDD_12), U2.36 (AVDD_13), U2.37 (AVDD_10), U2.39 (AVDD_15)
CBUS1: IC1.22 (CBUS1), JP1.2, R7.2, U1.60 (BOOT0)
CBUS2: IC1.13 (CBUS2), Q2.1 (B)
COM_1.8: U1.61 (PB8); also elsewhere on the board
COM_5V: U1.59 (PB7); also elsewhere on the board
CS_DDS: U1.46 (PA13), U2.47 (~CS)
CTL_DUPL: U1.30 (PB11); also elsewhere on the board
CTL_EM: U1.29 (PB10); also elsewhere on the board
CTL_RECEPT: U1.62 (PB9); also elsewhere on the board
DDS_V0: DDS_V0.1, TR2.P6 (P2); also elsewhere on the board
DDS_V1: DDS_V1.1, TR1.P6 (P2); also elsewhere on the board
GND: ADM1.1 (B), C1.2, C2.2, C3.2, C4.2, C5.2, C6.2, C7.2, C8.2, C9.2, C10.2, C11.2, C12.2, C13.2, C14.2, C15.2, C16.2, C17.2, C18.2, C19.2, C20.2, C21.2, C22.2, C23.2, C24.2, C25.2, C26.2, C27.2, C28.2, C29.2, C31.2, C32.2, D1.K, IC1.7 (GND), IC1.18 (GND), IC1.21 (GND), IC1.25 (GND), IC1.26 (TEST), J1.P1 (GND), J1.P3 (GND), J1.P4 (GND), J1.P5 (GND), Q2.2 (E), R6.1, R7.1, R16.1, R64.1, S1.2 (S), TR1.P4 (P1), TR2.P4 (P1), U1.12 (VSSA), U1.18 (VSS_4), U1.28 (PB1_2), U1.31 (VSS_1), U1.47 (VSS_2), U1.63 (VSS_3), U2.6 (AGND_6), U2.10 (AGND_2), U2.12 (AGND), U2.16 (AGND_4), U2.18 (AGND_5), U2.20 (AGND_3), U2.25 (AGND_7), U2.44 (DGND_2), U2.56 (DGND), U2.57 (EPAD), U3.2 (GND), X1.5, X1.M1 (GND1), X1.M2 (GND2), X1.M3 (GND3), X1.M4 (GND4), X2.5, X2.M1 (GND1), X2.M2 (GND2), X2.M3 (GND3), X2.M4 (GND4); also elsewhere on the board
IO_UP_DDS: U1.49 (PA14), U2.46 (I/O_UPDATE)
MAG: U1.26 (PB0); also elsewhere on the board
unnamed: R16.2, U2.17 (DAC_RSET)
unnamed: R19.2, U2.27 (LOOP_FILTER)
unnamed: C30.2, R19.1
unnamed: C28.1, Q4.P$1 (1), U2.22 (~REF_CLK)
unnamed: C29.1, Q4.P$3 (2), U2.23 (REF_CLK)
unnamed: R15.2, U2.24 (CLK_MODE_SEL)
unnamed: R17.1, TR2.P3 (S1), U2.13 (CH1_IOUT)
unnamed: R18.1, TR2.P1 (S3), U2.14 (~CH1_IOUT)
unnamed: R14.1, TR1.P1 (S3), U2.9 (~CH0_IOUT)
unnamed: R13.1, TR1.P3 (S1), U2.8 (CH0_IOUT)
unnamed: C24.1, C25.1, L1.1, U2.45 (DVDD), U2.55 (DVDD_2)
unnamed: R9.2, R60.2, X2.1
unnamed: J1.P2 (1), U3.1 (OUT), U3.4 (IN-)
unnamed: R61.2, U1.58 (PB6)
unnamed: R11.2, U1.44 (PA11)
unnamed: IC1.16 (USBDM), X1.2
unnamed: IC1.20 (VCC), R2.2, R55.2, X1.1
unnamed: R12.2, U1.45 (PA12)
unnamed: IC1.15 (USBDP), X1.3
unnamed: C9.1, IC1.17 (3V3OUT)
unnamed: IC1.1 (TXD), R1.1
unnamed: IC1.5 (RXD), R3.1
unnamed: C8.1, Q1.P$1 (1), U1.5 (PD0_OSC_IN)
unnamed: JP1.1, R5.2
unnamed: C7.1, Q1.P$3 (2), U1.6 (PD1_OSC_OUT)
unnamed: R11.1, X2.2
unnamed: D1.A2, R8.1
unnamed: C10.1, Q3.P$2 (2), U1.3 (PC14-OSC32_IN)
unnamed: C11.1, Q3.P$1 (1), U1.2 (PC13-TAMPER-RTC)
unnamed: D1.A1, R10.1
unnamed: R9.1, R12.1, X2.3
PA7: U1.23 (PA7)
PC1: R8.2, U1.9 (PC1)
PC2: R10.2, U1.10 (PC2)
PHASE: U1.27 (PB1); also elsewhere on the board
PWR_DWN: R61.1, U2.4 (PWR_DWN_CTL)
RESET_DDS: U1.50 (PA15), U2.3 (MASTER_RESET)
RESET_FTDI: IC1.19 (!RESET), R2.1, R6.2, U1.40 (PC9)
RSRX: R3.2, U1.42 (PA9)
RST: ADM1.2 (E), Q2.3 (C), R4.1, S1.1, U1.7 (NRST)
RSTX: R1.2, U1.43 (PA10)
SCLK: U1.34 (PB13), U2.48 (SCLK)
SDIO: U1.36 (PB15), U2.50 (SDIO_0)
SDIO_1: U1.14 (PA0-WKUP), U2.51 (SDIO_1)
SDIO_2: U1.15 (PA1), U2.52 (SDIO_2)
SDIO_3: R64.2, U1.16 (PA2), U2.53 (SDIO_3)
S_DAC: U1.21 (PA5), U3.3 (IN+)
VCC: C26.1, C27.1, C30.1, C31.1, C32.1, L1.2, L2.2, R13.2, R14.2, R15.1, R17.2, R18.2, TR1.P2 (S2), TR2.P2 (S2); also elsewhere on the board
V_COR_OFFSET: U1.20 (PA4); also elsewhere on the board
V_IN: R55.1, R60.1; also elsewhere on the board

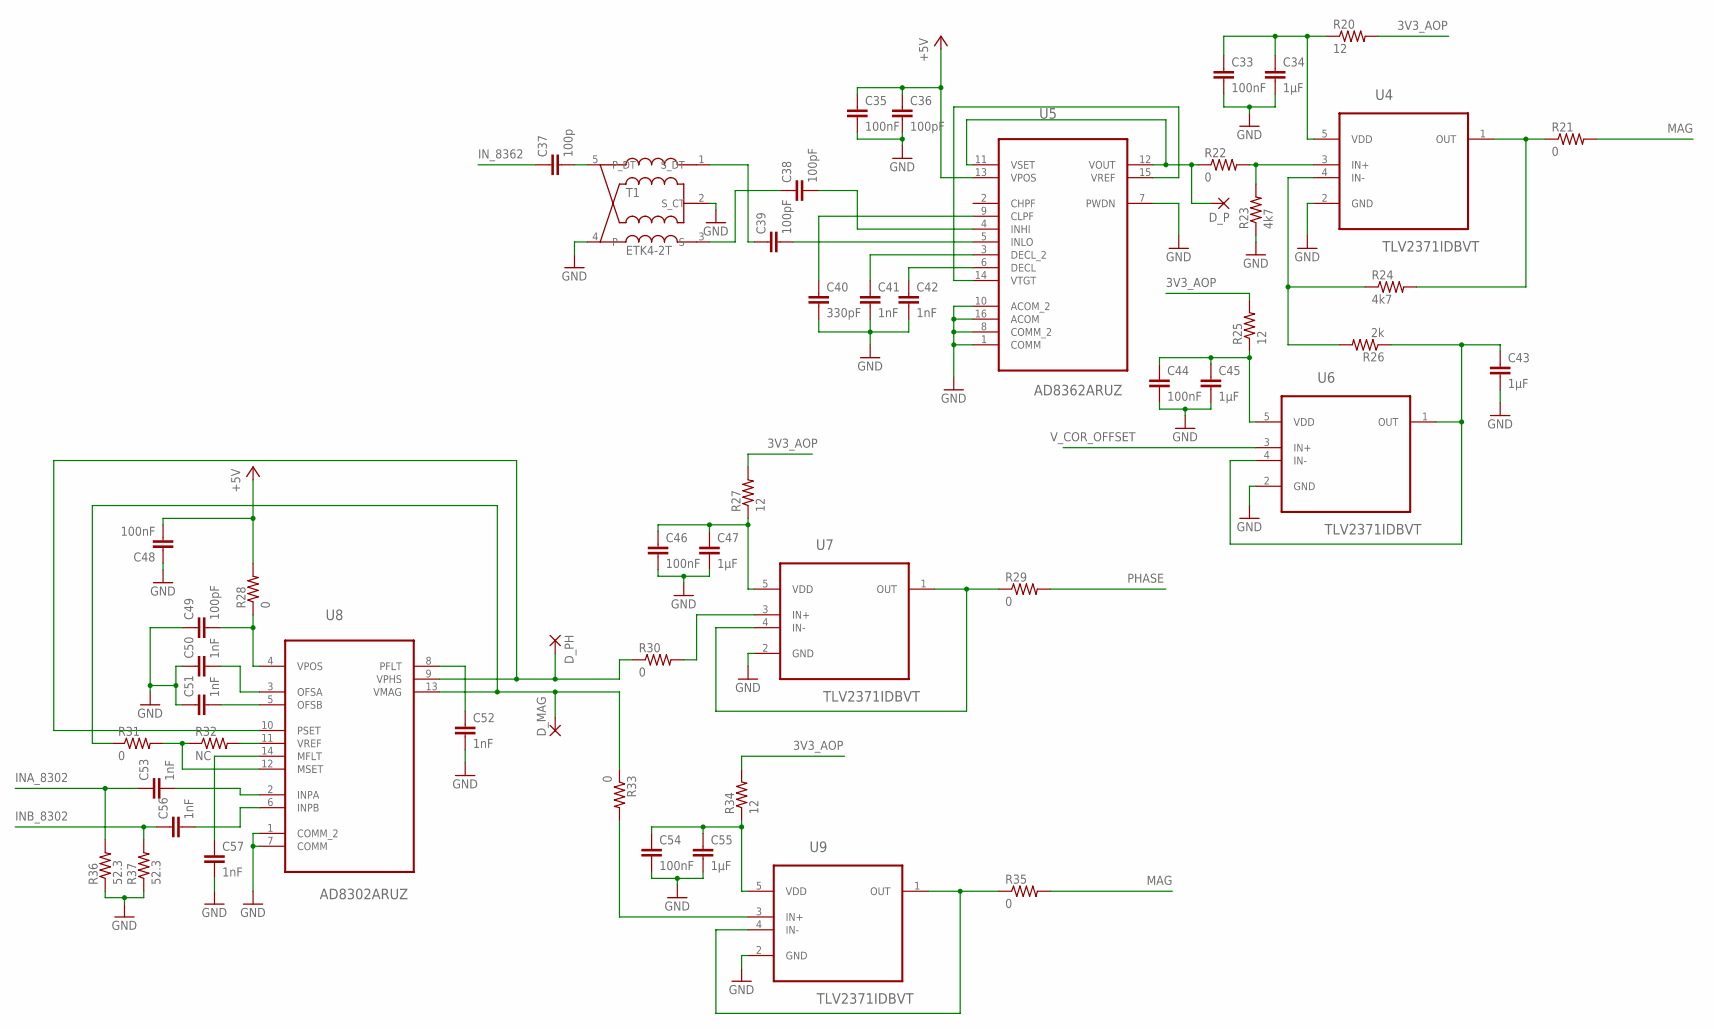
[picture p19: schematic new_sawtag_2012.sch, sheet 2]

Parts:
C33, C44, C46, C54: 100nF; C0402
C34, C43, C45, C47, C55: 1µF; C0603
C35, C48: 100nF; C0603
C36: 100pF; C0603
C37: 100p; C0402
C38, C39, C49: 100pF; C0402
C40: 330pF; C0603
C41, C42: 1nF; C0603
C50, C51, C52, C53, C56, C57: 1nF; C0402
D_MAG: 1,6/0,8
D_P: 1,6/0,8
D_PH: 1,6/0,8
R20, R25, R27, R34: 12; R0603
R21, R22, R28, R29, R30, R31, R33, R35: 0; R0603
R23, R24: 4k7; R0603
R26: 2k; R0603
R32: NC; R0603
R36, R37: 52.3; R0603
T1: ETK4-2T; SM-22
U4: TLV2371IDBVT; SOT95P280X145-5N
U5: AD8362ARUZ; SOP65P640X120-16N
U6, U7, U9: TLV2371IDBVT; SOT95P280X145-5N; MPN TLV2371IDBVT
U8: AD8302ARUZ; SOP65P640X120-14N

Connections:
3V3_AOP: R20.2, R25.2, R27.2, R34.2; also elsewhere on the board
+5V: C35.1, C36.1, C48.2, R28.2, U5.13 (VPOS); also elsewhere on the board
GND: C33.2, C34.2, C35.2, C36.2, C40.2, C41.2, C42.2, C43.2, C44.2, C45.2, C46.2, C47.2, C48.1, C49.1, C50.1, C51.1, C52.2, C54.2, C55.2, C57.2, R23.1, R36.1, R37.1, T1.2 (S_CT), T1.4, U4.2 (GND), U5.1 (COMM), U5.7 (PWDN), U5.8 (COMM_2), U5.10 (ACOM_2), U5.16 (ACOM), U6.2 (GND), U7.2 (GND), U8.1 (COMM_2), U8.7 (COMM), U9.2 (GND); also elsewhere on the board
INA_8302: C53.1, R36.2; also elsewhere on the board
INB_8302: C56.1, R37.2; also elsewhere on the board
IN_8362: C37.1; also elsewhere on the board
MAG: R21.2, R35.2; also elsewhere on the board
unnamed: D_P.1, R22.1, U5.11 (VSET), U5.12 (VOUT)
unnamed: R22.2, R23.2, U4.3 (IN+)
unnamed: C42.1, U5.6 (DECL)
unnamed: C41.1, U5.3 (DECL_2)
unnamed: C40.1, U5.9 (CLPF)
unnamed: C39.2, U5.5 (INLO)
unnamed: C38.2, U5.4 (INHI)
unnamed: R24.1, R26.2, U4.4 (IN-)
unnamed: U5.14 (VTGT), U5.15 (VREF)
unnamed: C43.1, R26.1, U6.1 (OUT), U6.4 (IN-)
unnamed: C33.1, C34.1, R20.1, U4.5 (VDD)
unnamed: C50.2, U8.3 (OFSA)
unnamed: C51.2, U8.5 (OFSB)
unnamed: C53.2, U8.2 (INPA)
unnamed: C56.2, U8.6 (INPB)
unnamed: C44.1, C45.1, R25.1, U6.5 (VDD)
unnamed: C49.2, R28.1, U8.4 (VPOS)
unnamed: R30.2, U7.3 (IN+)
unnamed: R29.1, U7.1 (OUT), U7.4 (IN-)
unnamed: R33.2, U9.3 (IN+)
unnamed: R35.1, U9.1 (OUT), U9.4 (IN-)
unnamed: C46.1, C47.1, R27.1, U7.5 (VDD)
unnamed: C54.1, C55.1, R34.1, U9.5 (VDD)
unnamed: D_MAG.1, R31.1, R33.1, U8.13 (VMAG)
unnamed: D_PH.1, R30.1, U8.9 (VPHS), U8.10 (PSET)
unnamed: C39.1, T1.1 (S_DT)
unnamed: C38.1, T1.3 (S)
unnamed: C57.1, U8.14 (MFLT)
unnamed: C52.1, U8.8 (PFLT)
unnamed: C37.2, T1.5 (P_DT)
unnamed: R21.1, R24.2, U4.1 (OUT)
unnamed: R31.2, R32.1, U8.12 (MSET)
unnamed: R32.2, U8.11 (VREF)
PHASE: R29.2; also elsewhere on the board
V_COR_OFFSET: U6.3 (IN+); also elsewhere on the board

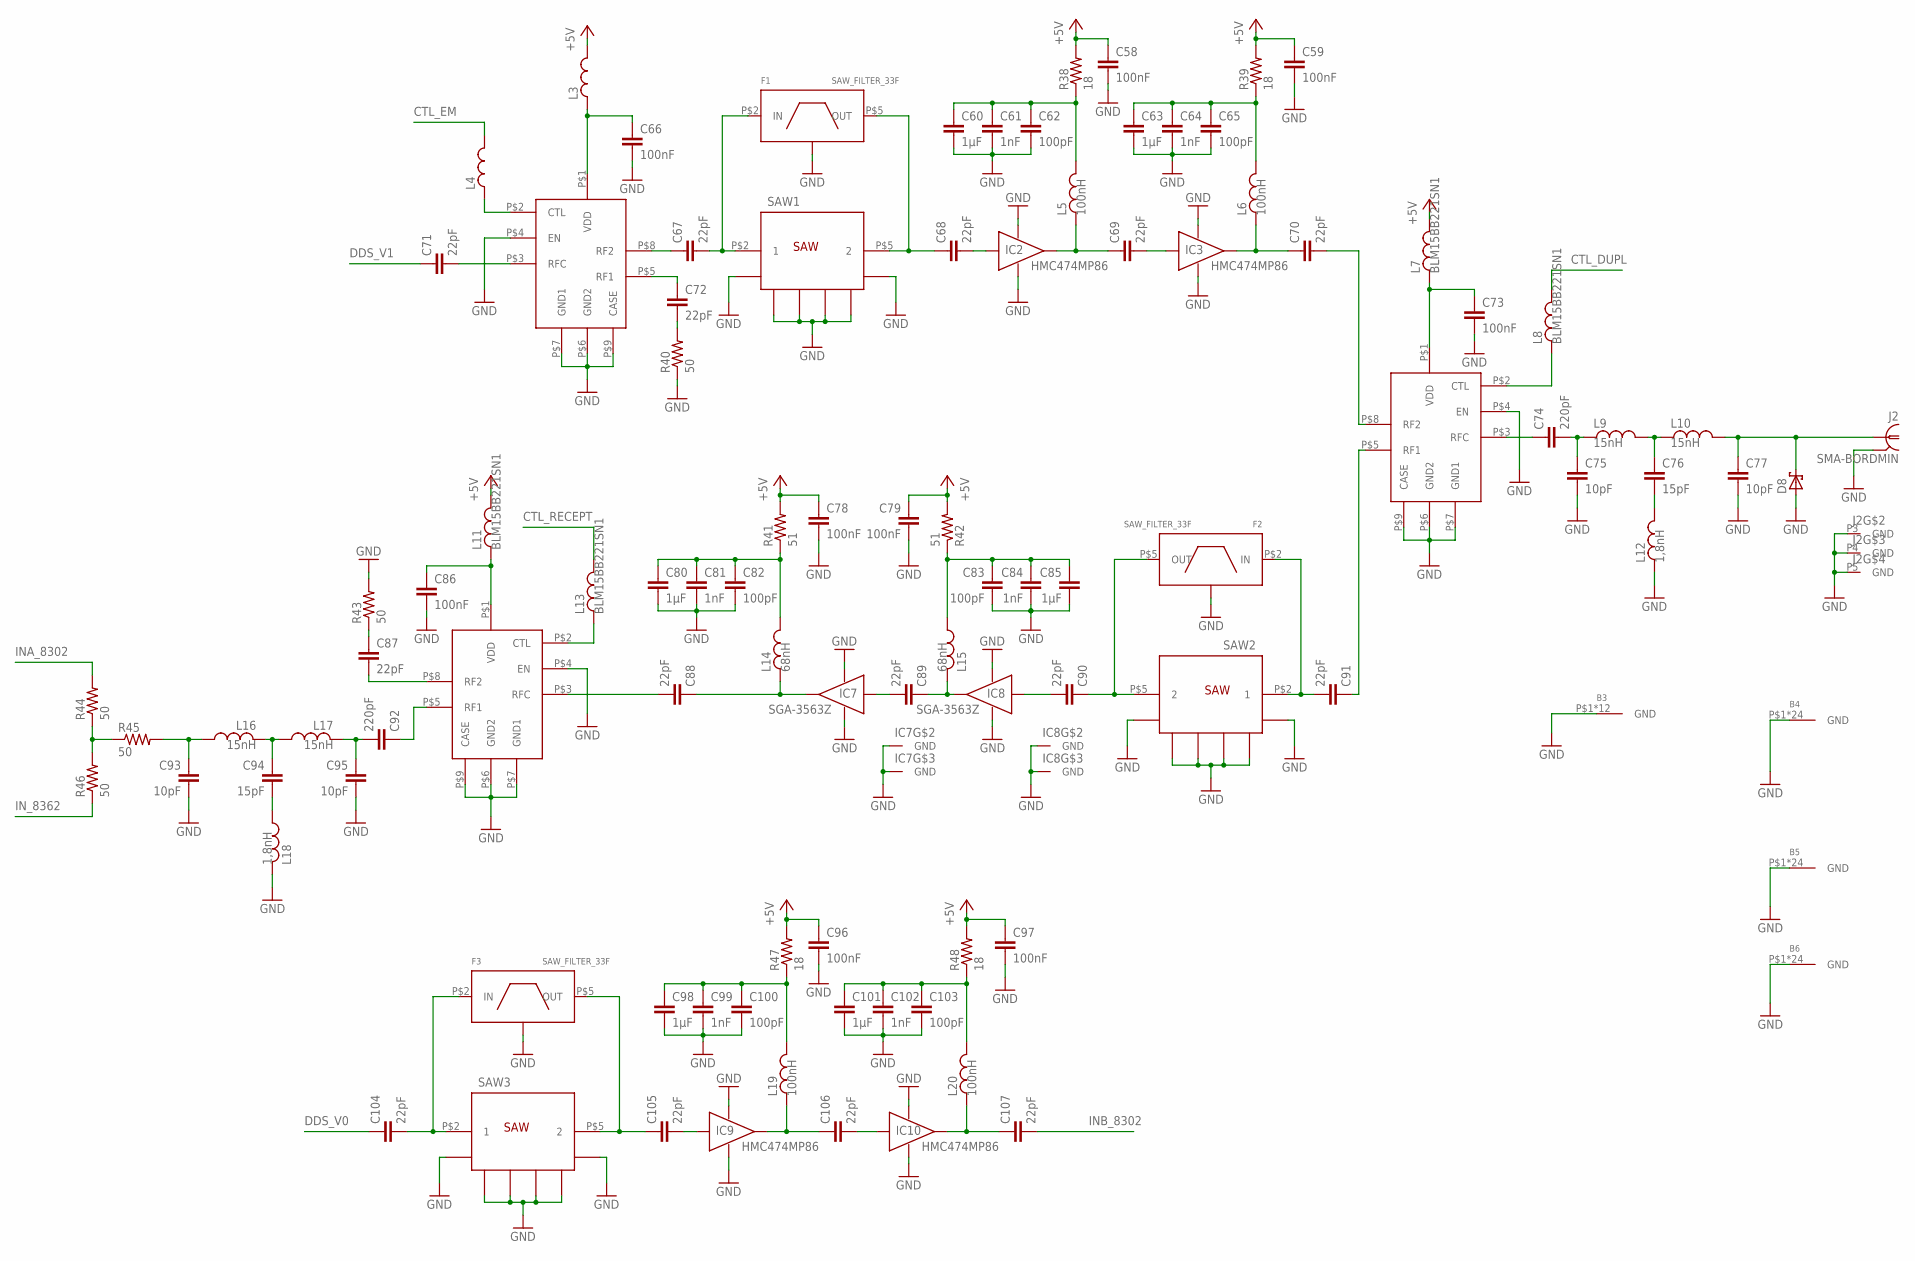
[picture p20: schematic new_sawtag_2012.sch, sheet 3]

Parts:
B3: BMIS-102
B4, B5, B6: BMIS-205
C58, C59, C66, C78, C79, C86, C96, C97: 100nF; C0603
C60, C63, C80, C85, C98, C101: 1µF; C0603
C61, C64, C81, C84, C99, C102: 1nF; C0402
C62, C65, C82, C83, C100, C103: 100pF; C0402
C67, C68, C69, C70, C71, C72, C87, C88, C89, C90, C91, C104, C105, C106, C107: 22pF; C0402
C73: 100nF; C0402
C74, C92: 220pF; C0402
C75, C77, C93, C95: 10pF; C0402
C76, C94: 15pF; C0402
D8: SMF5.0AT1; SOD123FL
F1, F2, F3: SAW_FILTER_33F; BOITIER_3-3
IC2, IC3, IC9, IC10: HMC474MP86; VV105
IC4, IC5, IC6: HMC349MS8G; SMT-MS8G
IC7, IC8: SGA-3563Z; SOT363
J2: SMA-BORDMIN; SMA_BORDMIN
L3, L4: L_0402; 0402
L5, L6, L19, L20: 100nH; 0603
L7, L8, L11, L13: BLM15BB221SN1; 0402
L9, L10, L16, L17: 15nH; 0603
L12, L18: 1,8nH; 0603
L14, L15: 68nH; 0603
R38, R39, R47, R48: 18; R0603
R40: 50; R0603
R41, R42: 51; R0603
R43, R44, R45, R46: 50; R0402
SAW1, SAW2, SAW3: SAW_DBLPORT; BOITIER_5-5

Connections:
+5V: C58.1, C59.1, C78.1, C79.1, C96.1, C97.1, L3.2, L7.2, L11.2, R38.2, R39.2, R41.2, R42.2, R47.2, R48.2; also elsewhere on the board
CTL_DUPL: L8.2; also elsewhere on the board
CTL_EM: L4.2; also elsewhere on the board
CTL_RECEPT: L13.2; also elsewhere on the board
DDS_V0: C104.1; also elsewhere on the board
DDS_V1: C71.1; also elsewhere on the board
GND: B3.P$1, B3.P$2, B3.P$3, B3.P$4, B3.P$5, B3.P$6, B3.P$7, B3.P$8, B3.P$9, B3.P$10, B3.P$11, B3.P$12, B4.P$1, B4.P$2, B4.P$3, B4.P$4, B4.P$5, B4.P$6, B4.P$7, B4.P$8, B4.P$9, B4.P$10, B4.P$11, B4.P$12, B4.P$13, B4.P$14, B4.P$15, B4.P$16, B4.P$17, B4.P$18, B4.P$19, B4.P$20, B4.P$21, B4.P$22, B4.P$23, B4.P$24, B5.P$1, B5.P$2, B5.P$3, B5.P$4, B5.P$5, B5.P$6, B5.P$7, B5.P$8, B5.P$9, B5.P$10, B5.P$11, B5.P$12, B5.P$13, B5.P$14, B5.P$15, B5.P$16, B5.P$17, B5.P$18, B5.P$19, B5.P$20, B5.P$21, B5.P$22, B5.P$23, B5.P$24, B6.P$1, B6.P$2, B6.P$3, B6.P$4, B6.P$5, B6.P$6, B6.P$7, B6.P$8, B6.P$9, B6.P$10, B6.P$11, B6.P$12, B6.P$13, B6.P$14, B6.P$15, B6.P$16, B6.P$17, B6.P$18, B6.P$19, B6.P$20, B6.P$21, B6.P$22, B6.P$23, B6.P$24, C58.2, C59.2, C60.2, C61.2, C62.2, C63.2, C64.2, C65.2, C66.2, C73.2, C75.2, C77.2, C78.2, C79.2, C80.2, C81.2, C82.2, C83.2, C84.2, C85.2, C86.2, C93.2, C95.2, C96.2, C97.2, C98.2, C99.2, C100.2, C101.2, C102.2, C103.2, D8.A, F1.P$1, F1.P$3 (GND), F1.P$4 (GND), F1.P$6 (GND), F2.P$1, F2.P$3 (GND), F2.P$4 (GND), F2.P$6 (GND), F3.P$1, F3.P$3 (GND), F3.P$4 (GND), F3.P$6 (GND), IC2.2 (V_1), IC2.4 (V_2), IC3.2 (V_1), IC3.4 (V_2), IC4.P$4 (EN), IC4.P$6 (GND2), IC4.P$7 (GND1), IC4.P$9 (CASE), IC5.P$4 (EN), IC5.P$6 (GND2), IC5.P$7 (GND1), IC5.P$9 (CASE), IC6.P$4 (EN), IC6.P$6 (GND2), IC6.P$7 (GND1), IC6.P$9 (CASE), IC7.P$1 (V_1), IC7.P$2 (GND), IC7.P$4 (V_2), IC7.P$5 (GND), IC8.P$1 (V_1), IC8.P$2 (GND), IC8.P$4 (V_2), IC8.P$5 (GND), IC9.2 (V_1), IC9.4 (V_2), IC10.2 (V_1), IC10.4 (V_2), J2.P1 (GND), J2.P3 (GND), J2.P4 (GND), J2.P5 (GND), L12.1, L18.1, R40.1, R43.2, SAW1.P$1 (GND1), SAW1.P$3 (GND2), SAW1.P$4 (GND3), SAW1.P$6 (GND4), SAW1.P$7 (GND5), SAW1.P$8 (GND6), SAW2.P$1 (GND1), SAW2.P$3 (GND2), SAW2.P$4 (GND3), SAW2.P$6 (GND4), SAW2.P$7 (GND5), SAW2.P$8 (GND6), SAW3.P$1 (GND1), SAW3.P$3 (GND2), SAW3.P$4 (GND3), SAW3.P$6 (GND4), SAW3.P$7 (GND5), SAW3.P$8 (GND6); also elsewhere on the board
INA_8302: R44.2; also elsewhere on the board
INB_8302: C107.2; also elsewhere on the board
IN_8362: R46.1; also elsewhere on the board
unnamed: C67.2, F1.P$2 (IN), SAW1.P$2 (1)
unnamed: C67.1, IC4.P$8 (RF2)
unnamed: C70.1, IC3.3 (OUT), L6.1
unnamed: C68.1, F1.P$5 (OUT), SAW1.P$5 (2)
unnamed: C68.2, IC2.1 (IN)
unnamed: C63.1, C64.1, C65.1, L6.2, R39.1
unnamed: C72.1, IC4.P$5 (RF1)
unnamed: C60.1, C61.1, C62.1, L5.2, R38.1
unnamed: C69.1, IC2.3 (OUT), L5.1
unnamed: C69.2, IC3.1 (IN)
unnamed: C72.2, R40.2
unnamed: C91.2, F2.P$2 (IN), SAW2.P$2 (1)
unnamed: C91.1, IC5.P$5 (RF1)
unnamed: C90.1, F2.P$5 (OUT), SAW2.P$5 (2)
unnamed: C90.2, IC8.P$3 (IN)
unnamed: C89.1, IC8.P$6 (OUT), L15.1
unnamed: C83.1, C84.1, C85.1, L15.2, R42.1
unnamed: C88.1, IC7.P$6 (OUT), L14.1
unnamed: C80.1, C81.1, C82.1, L14.2, R41.1
unnamed: C89.2, IC7.P$3 (IN)
unnamed: C70.2, IC5.P$8 (RF2)
unnamed: C92.1, IC6.P$5 (RF1)
unnamed: C87.2, IC6.P$8 (RF2)
unnamed: C74.1, IC5.P$3 (RFC)
unnamed: C74.2, C75.1, L9.1
unnamed: C76.1, L9.2, L10.1
unnamed: C76.2, L12.2
unnamed: C77.1, D8.C, J2.P2 (1), L10.2
unnamed: C88.2, IC6.P$3 (RFC)
unnamed: C87.1, R43.1
unnamed: C73.1, IC5.P$1 (VDD), L7.1
unnamed: C92.2, C95.1, L17.1
unnamed: C94.1, L16.1, L17.2
unnamed: C94.2, L18.2
unnamed: C93.1, L16.2, R45.2
unnamed: IC5.P$2 (CTL), L8.1
unnamed: C66.1, IC4.P$1 (VDD), L3.1
unnamed: C71.2, IC4.P$3 (RFC)
unnamed: C86.1, IC6.P$1 (VDD), L11.1
unnamed: IC4.P$2 (CTL), L4.1
unnamed: IC6.P$2 (CTL), L13.1
unnamed: R44.1, R45.1, R46.2
unnamed: C104.2, F3.P$2 (IN), SAW3.P$2 (1)
unnamed: C105.1, F3.P$5 (OUT), SAW3.P$5 (2)
unnamed: C105.2, IC9.1 (IN)
unnamed: C98.1, C99.1, C100.1, L19.2, R47.1
unnamed: C106.1, IC9.3 (OUT), L19.1
unnamed: C106.2, IC10.1 (IN)
unnamed: C107.1, IC10.3 (OUT), L20.1
unnamed: C101.1, C102.1, C103.1, L20.2, R48.1

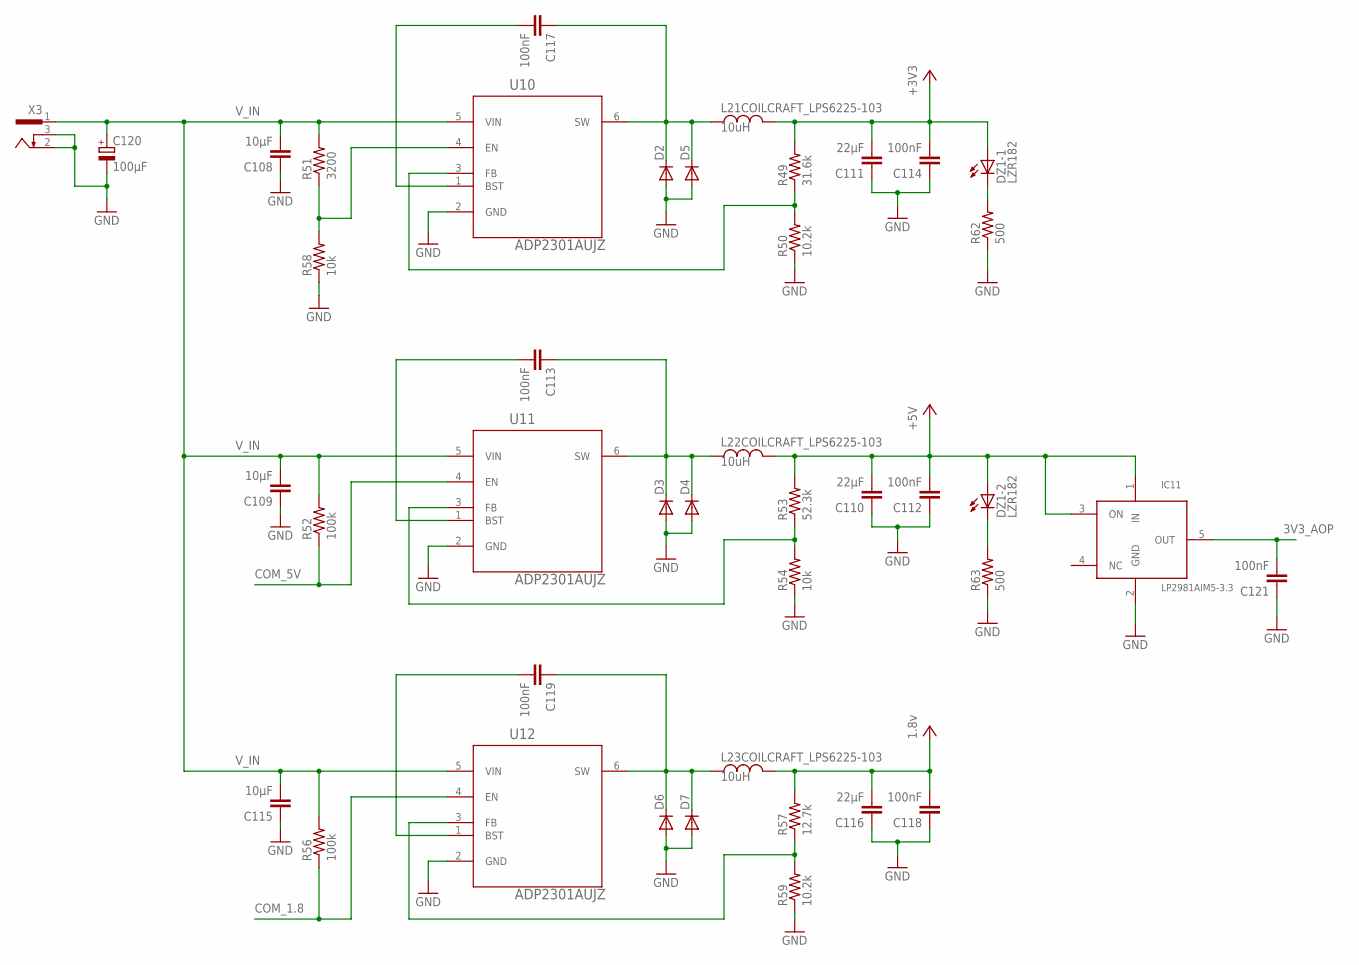
[picture p21: schematic new_sawtag_2012.sch, sheet 4]

Parts:
C108, C109, C115: 10µF; C0805
C110, C111, C116: 22µF; C0805
C112, C113, C114, C117, C118, C121: 100nF; C0805
C119: 100nF; C0603
C120: 100µF; 140CLH-1010
D2, D3, D6: DIODE-SMB; SMB
D4, D5, D7: DIODE-SMC; SMC
DZ1: LZR182
IC11: LP2981AIM5-3.3; SOT23-M5
L21COILCRAFT_LPS6225-103, L22COILCRAFT_LPS6225-103, L23COILCRAFT_LPS6225-103: 10uH; L_DCDC_6*6
R49: 31.6k; R0603
R50, R59: 10.2k; R0603
R51: 3200; R0603
R52, R56: 100k; R0603
R53: 52.3k; R0603
R54, R58: 10k; R0603
R57: 12.7k; R0603
R62, R63: 500; R0402
U10, U11, U12: ADP2301AUJZ; SOT95P280X90-6N
X3: 733980-62

Connections:
3V3_AOP: C121.2, IC11.5 (OUT); also elsewhere on the board
+3V3: C111.2, C114.2, DZ1.A1 (A), L21COILCRAFT_LPS6225-103.P$2 (2), R49.2; also elsewhere on the board
+5V: C110.2, C112.2, DZ1.A2 (A), IC11.1 (IN), IC11.3 (ON), L22COILCRAFT_LPS6225-103.P$2 (2), R53.2; also elsewhere on the board
COM_1.8: R56.1, U12.4 (EN); also elsewhere on the board
COM_5V: R52.1, U11.4 (EN); also elsewhere on the board
GND: C108.1, C109.1, C110.1, C111.1, C112.1, C114.1, C115.1, C116.1, C118.1, C120.-, C121.1, D2.A, D3.A, D4.A, D5.A, D6.A, D7.A, IC11.2 (GND), R50.1, R54.1, R58.1, R59.1, R62.1, R63.1, U10.2 (GND), U11.2 (GND), U12.2 (GND), X3.2, X3.3; also elsewhere on the board
unnamed: C113.1, D3.C, D4.C, L22COILCRAFT_LPS6225-103.P$1 (1), U11.6 (SW)
unnamed: C117.1, D2.C, D5.C, L21COILCRAFT_LPS6225-103.P$1 (1), U10.6 (SW)
unnamed: R49.1, R50.2, U10.3 (FB)
unnamed: R53.1, R54.2, U11.3 (FB)
unnamed: C117.2, U10.1 (BST)
unnamed: DZ1.K1 (C), R62.2
unnamed: R51.1, R58.2, U10.4 (EN)
unnamed: C113.2, U11.1 (BST)
unnamed: C119.1, D6.C, D7.C, L23COILCRAFT_LPS6225-103.P$1 (1), U12.6 (SW)
unnamed: R57.1, R59.2, U12.3 (FB)
unnamed: C119.2, U12.1 (BST)
unnamed: DZ1.K2 (C), R63.2
VCC: C116.2, C118.2, L23COILCRAFT_LPS6225-103.P$2 (2), R57.2; also elsewhere on the board
V_IN: C108.2, C109.2, C115.2, C120.+, R51.2, R52.2, R56.2, U10.5 (VIN), U11.5 (VIN), U12.5 (VIN), X3.1; also elsewhere on the board

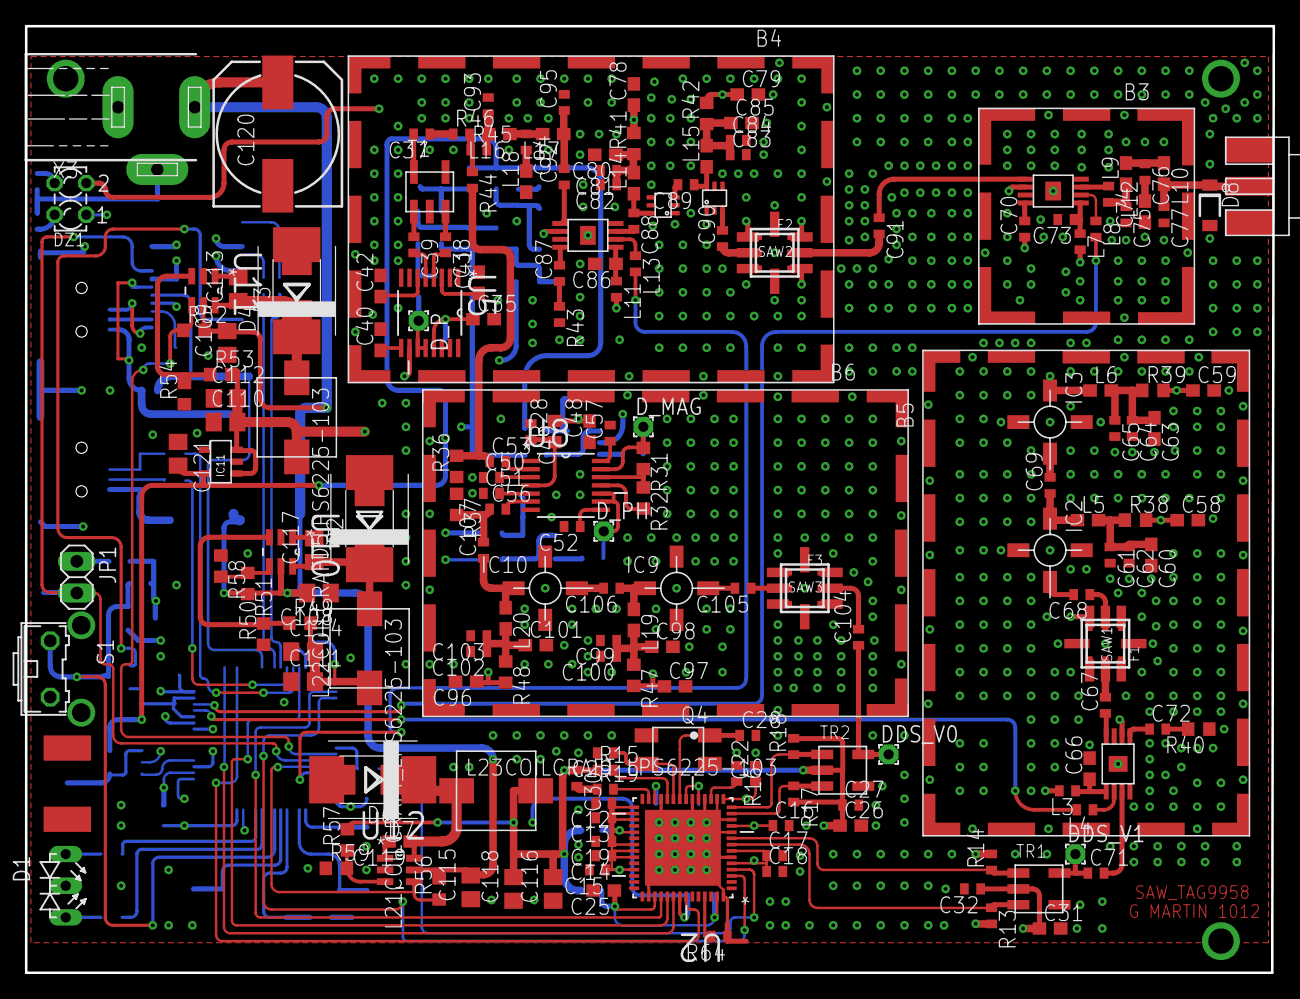
[picture p22: board new_sawtag_2012.brd from above]

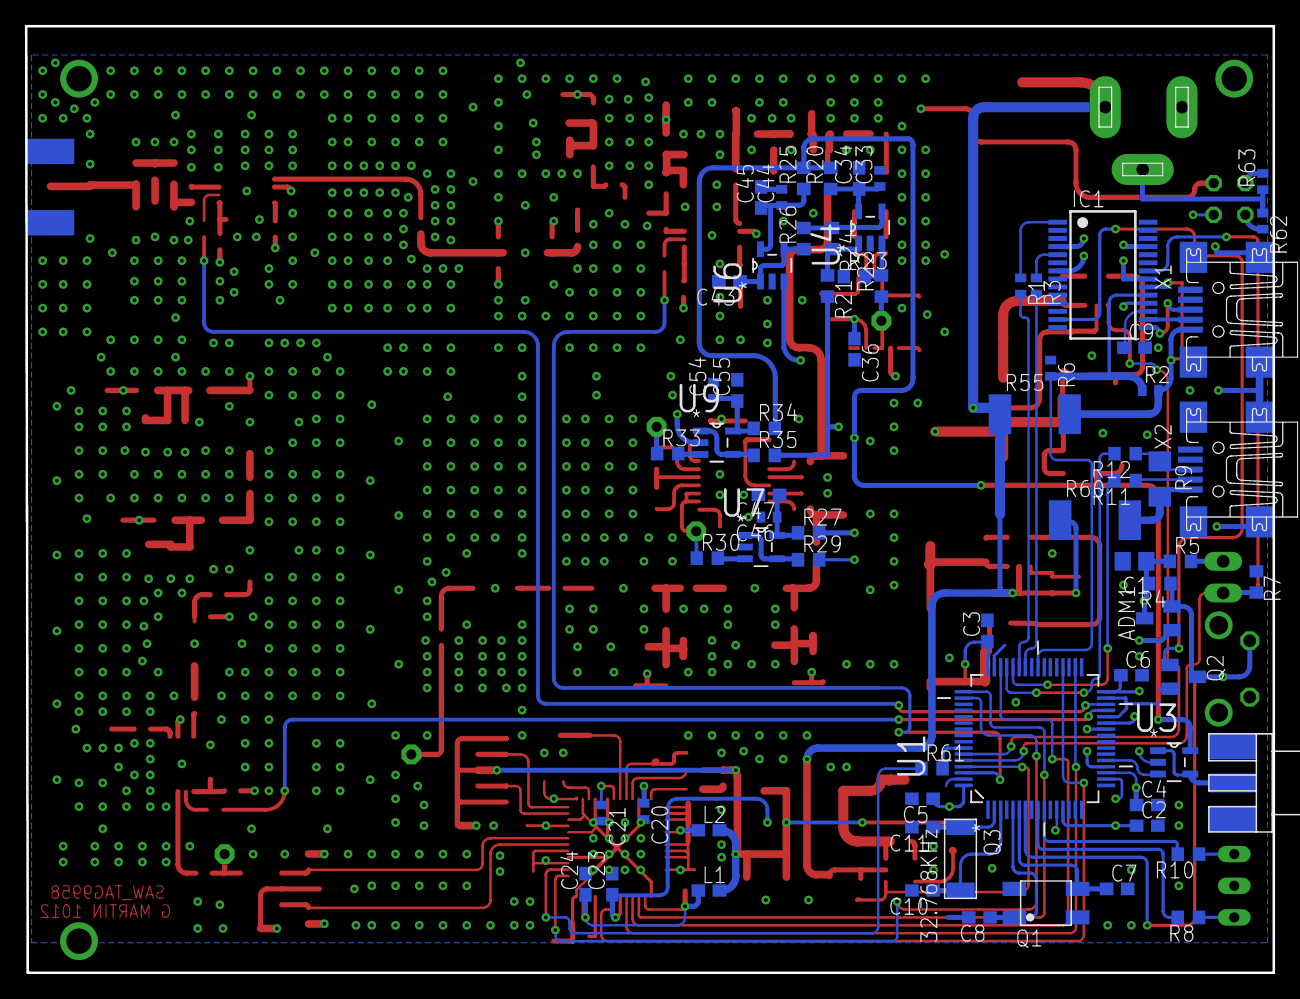
[picture p23: board new_sawtag_2012.brd from below]

Board: 4 copper layers, 100.1 x 76.0 mm, 270 parts (71 on the bottom side), 164 nets.
