jmfriedt/sensor/DDSvar.c

#include "DDSinc.h"

//----------------------------------------------------------------------------//
int safran_temperature=1;    // sortie DAC safran
int convertit_temperature=0; // affiche la temperature en degC, exploitant A0..A2
// exploitation de bandes de frequences predefinies (1) ou recherche
//   de NBPIPCS dans la bande fstart[0]..fstop[NBPICS-1] (0), modif par AT=
int bandes=1;  // 0=pas de bande predefinie, ou 1=exploitation des bandes
               // -> NBPICS*NBSTEPS mesures

// choix du mode de mesure (2points ou fixe/3points), modifiable par AT!
unsigned char deux_points=0; // 0=fixe/3points, 1=2 points

// choix du mode de detection peigne fixe/3 points, modifiable par AT3
unsigned char mode_balayage_continu=1; // 0=3 points, 1=peigne fixe

unsigned char affiche_rs232=1; // 1=affiche ; 0=n'affiche pas

//-----------------------------------------------------------------------------/
int LBT=0;	        // interroge que si la bande est silencieuse, 0/1 (ATL)
#ifndef gilloux
unsigned char agc=1;    // activer (1) controle de gain automatique, 0/1 (ATZ)
#else
unsigned char agc=1;    // activer (1) controle de gain automatique, 0/1 (ATZ)
#endif
unsigned char trame_minimale=0; // virer les messages inutiles si trame_minimale==1

int ATTENTE=0; 	        // attente entre deux emissions	(0..65536)   
                        // 2000 = 1.1 ms entre deux emissions, 2800=1.55 ms
int HATTENTE=1;         // entre fin d'emission et conversion (0..65536)

int RS_BAUDRATE=57600;  // debit de communication (bauds)
int RS_PARITY=0;        // 0=None, 1=Odd, 2=Even

//----------------------------------------------------------------------------//
//      CHOIX DU TYPE DE DETECTION:
//----------------------------------------------------------------------------//
// 2 types possibles: 
//              -> Détection de tous les resonateur en meme temps par la 
//                   fonction balaie_ism #define detec_tous
//              -> Sinon detection des resonateur un par un (permet d'avoir 
//                   plus de resonateurs)   

/**************************** CAS DES BORNES AUTOMATIQUES *********************/
#ifndef manuel    // cas des bornes equidistantes calculees automatiquement
unsigned int NBMES=(1);    // DOIT etre inferieur ou egal a NBMES_MAX
unsigned int NBMOY=(16);    // DOIT etre inferieur ou egal a NBMOY_MAX
unsigned int NBPICS=(2);   // DOIT etre inferieur ou egal a NBPICS_MAX
unsigned int NBSTEPS=(128); // NBSTEPS tq pas de freq=largeur mi-hauteur/3=f0/Q/3 
                  //         Min 26 steps avec Ampl:500 pour 36 db
unsigned int ANTENNES=(1); // DOIT etre inferieur ou egal a ANTENNES_MAX

#ifndef f400      // cas de l'oscillateur du DDS a 200 MHz (habituel)

//unsigned int FSTART =(0x2a2d0e00); // 432.95 jerome 130218
unsigned int FSTOP  =(0x2bf7cf00); // 434.35 jerome 130218
//unsigned int FSTART =(0x27ced900); // 431.1 silmach
//unsigned int FSTOP  =(0x28f5c300); // 432.7 silmach  nbpics=2  milieu = 
//unsigned int FSTART =(0x270a3d00); // LMD 32.57
//unsigned int FSTOP  =(0x29999a00); // LMD 34.57
//unsigned int FSTART =(0x29b08A00); // LMD 32.57
//unsigned int FSTOP  =(0x2c3fe600); // LMD 34.57
//unsigned int FSTART =(0x26666700); // 430.0
//unsigned int FSTOP  =(0x3ffff000); // 450.00
//unsigned int FSTOP  =(0x2f5c3000); // 437.0  // beanair 121123
//unsigned int FSTOP  =(0x347AE200); // 441.0  // beanair 121123
//unsigned int FSTOP  =(0x370a3d00); // 443.0
unsigned int FSTART =(0x27ae1500); // 431.0
//unsigned int FSTART =(0x28f5c300); // 432.00 // BMCI .. 435

//unsigned int FSTOP  =(0x2E147B00); // 436 // damien LMA : 2 moy, 1 pic
//unsigned int FSTART =(0x2CCCCD00); // 435

//unsigned int FSTART=(0x2A4DD300);  // 433.05     SEAS10    
//unsigned int FSTOP =(0x2c290000);  // 435.00 MHz SAFRAN
//unsigned int FSTOP =(0x2ccc0000);  // 435.00 MHz SEAS10
//unsigned int FSTART =(0x2A3D7000); // 433.0   avangroup
//unsigned int FSTOP  =(0x36666600); // 442.5 MHz avangroup 
//unsigned int FSTOP  =(0x3C28F600); // 447.00 MHz SAWHOT

//unsigned int FSTOP  =(0x2b851f00); // 434.000 Siemens couple avec debut a 433

//unsigned int FSTART =(0x29999900); // 432.5   alstom
//unsigned int FSTOP  =(0x3E147A00); // 448.5 MHz avangroup 
//unsigned int FSTART =(0x2A3D7000); // 433  tests sylvain pression 
//unsigned int FSTOP  =(0x2C28F500); // 444.5 MHz 

//unsigned int FSTART =(0x35810600); // 441.8  tests alstom 
//unsigned int FSTOP  =(0x3a9fbe00); // 430.00 MHz SAWHOT : bande = 0, NBSTEPS_MAX=808, NBSTEPS=800
//unsigned int FSTART =(0x2eb85100); // 436.5  tests alexandre
//unsigned int FSTOP  =(0x41eb8500); // 451.50 MHz  tests alexandre
//unsigned int FSTART =(0x2b851f00); // 434.0 
//unsigned int FSTOP  =(0x2f9db200); // 437.2 
//unsigned int FSTOP  =(0x2C28F500); // 444.5 MHz 
//unsigned int FSTOP  =(0x39900000); // 443.00 MHz SAWHOT

//unsigned int FSTART =(0x29AD4300); // 432.56     siemens1
//unsigned int FSTOP  =(0x2c3c9f00); // 434.56 MHz siemens1
//unsigned int FSTART =(0x28D4FE00); // 431.90     siemens2
//unsigned int FSTOP  =(0x2CEA4B00); // 435.09 MHz siemens2
//unsigned int FSTART =(0x2a4dd300); // 432.69     shiso
//unsigned int FSTOP  =(0x2f5c2900); // 434.69 MHz shiso

//unsigned int FSTART=(0x270a3d70); // 430.5 MHz jay
//unsigned int FSTOP =(0x3f5c2900); // 449.5 MHz jay
//unsigned int FSTART=(0x2b851f00); // 434 MHz sakharov
//unsigned int FSTOP =(0x35c29000); // 442 MHz sakharov
/// unsigned int FSTOP=(0x33333300); // 440 MHz sakharov
//unsigned int FSTOP =(0x3d70a000); // 448 MHz sakharov

//unsigned int FSTART=(0x29fbe800); // 432.80 irlande
//unsigned int FSTOP =(0x2c91d100); // 434.82 MHz
//unsigned int FSTART =(0x2Ac08300); // 433.400 Schrader 12/10/2011
//unsigned int FSTOP  =(0x2c2f8400); // 434.520 Schrader 12/10/2011
//unsigned int FSTART =(0x2a8c1500); // 433.400 Schrader 12/03/2012
//unsigned int FSTOP  =(0x2c01a400); // 434.520 Schrader 12/03/2012
//unsigned int FSTOP   =(0x2d70a400); // 435.50 MHz
//unsigned int FSTART =(0x2872b000);   // 431.6
//unsigned int FSTOP   =(0x2b020c00);  // 433.60 MHz
//unsigned int FSTART =(0x2a9fb300); // 433.

//unsigned int FSTART =(0x30000000); // 437.5  MHz Avangroup
//unsigned int FSTART  =(0x370a3d00); // 443.00 MHz Avangroup
//unsigned int FSTOP  =(0x3999a000); // 445.00 MHz 
//unsigned int FSTART  =(0x30a3d700); // 438.00 MHz 
//unsigned int FSTOP   =(0x2f5c2900); // 437.00 MHz 
//unsigned int FSTOP  =(0x31eb8500); // 439.00 MHz 
//unsigned int FSTOP  =(0x3f5c2900); // 439.00 MHz 
#else             // cas de l'oscillateur du DDS a 400 MHz (schrader SAWHOT) 
#ifndef AD9958
unsigned int FSTART =(0x2A4DD400/2); // SEAS10
unsigned int FSTOP  =(0x2c96d000/2); // SEAS10
#else  // cas du AD9958 : Fck=360 MHz et on genere entre 73 et 75 MHz
unsigned int FSTART =(0x46060600); // SEAS10 pour 340 MHz = 93 MHz  <- bon
//unsigned int FSTART =(0x45a5a600); // SEU010 pour 340 MHz = 92.5 MHz  <- bon
unsigned int FSTOP  =(0x47878800); // SEAS10 pour 340 MHz = 95 MHz  <- bon
//unsigned int FSTOP =(0x4d2d2d00); // Seb pour 340 MHz = 102.5 MHz  <- bon
//unsigned int FSTART  =(0x46c6c700); // Seb pour 340 MHz = 94 MHz  <- bon
//unsigned int FSTART =(0x33e93f00); // SEAS10 pour 360 MHz
//unsigned int FSTOP  =(0x35555600); // SEAS10 pour 360 MHz
#endif
//unsigned int FSTART =(0x27ae1500/2); // 431.0 silmach
//unsigned int FSTOP  =(0x28f5c300/2); // 432.7 silmach  nbpics=2
#endif
// dans le cas #undef manual, on remplira manuellement ces tableaux dans main()
unsigned int Fintsta[ANTENNES_MAX*NBPICS_MAX]; // ne pas toucher
unsigned int Fintsto[ANTENNES_MAX*NBPICS_MAX]; // ne pas toucher

/**************************** CAS DES BORNES MANUELLES ************************/
#else             // cas #ifdef manuel : definition manuelle des bornes de freq
int NBMES=(1);    // DOIT etre inferieur ou egal a NBMES_MAX
int NBMOY=(8);    // DOIT etre inferieur ou egal a NBMOY_MAX
unsigned int NBPICS=(4); // 12 ou 30   // DOIT etre inferieur ou egal a NBPICS_MAX
int NBSTEPS=(68); // NBSTEPS tq pas de freq=largeur mi-hauteur/3=f0/Q/3  
int ANTENNES=(1);   // inferieur ou egal a ANTENNES_MAX (Nombre d'antenne balayer)

#ifndef f400      // cas de l'oscillateur du DDS a 200 MHz (habituel)
// jay 121129 plastic
//unsigned int Fintsta[ANTENNES_MAX*NBPICS_MAX]={0x2A7EF9DB,0x2BA5E353,0x2CCCCCCC,0x2E147AE1,0x2F5C28F5,0x30A3D70A,0x31EB851E,0x33333333,0x347AE147,0x35C28F5C,0x370A3D70,0x3851EB85}; // 433,2 - 434,1 - 435,0 - 436,0 - 437,0 - 438,0 - 439,0 - 440,0 - 441,0 - 442,0 - 443,0 - 444,0
//unsigned int Fintsto[ANTENNES_MAX*NBPICS_MAX]={0x2BA5E353,0x2CCCCCCC,0x2E147AE1,0x2F5C28F5,0x30A3D70A,0x31EB851E,0x33333333,0x347AE147,0x35C28F5C,0x370A3D70,0x3851EB85,0x39999999}; // 434,1 - 435,0 - 436,0 - 437,0 - 438,0 - 439,0 - 440,0 - 441,0 - 442,0 - 443,0 - 444,0 - 445,0

// Fintsta contient autant de frequences de debut de plage que ANTENNES*NBPICS
// Fintsto contient autant de frequences de fin de plage que ANTENNES*NBPICS
// Alstom decembre 2015
// B5A10 434-442 443-447
// unsigned int Fintsta[ANTENNES_MAX*NBPICS_MAX]={0x2b851e00,0x370a3d00}; 
// unsigned int Fintsto[ANTENNES_MAX*NBPICS_MAX]={0x35c28f00,0x3c28f500};

// F2G9 436.5-444.5 444.5-448
//unsigned int Fintsta[ANTENNES_MAX*NBPICS_MAX]={0x2eb85100,0x38f5c200};           
//unsigned int Fintsto[ANTENNES_MAX*NBPICS_MAX]={0x38f5c200,0x3d70a300};

// F4D10 434.5-442.5 442-446
// unsigned int Fintsta[ANTENNES_MAX*NBPICS_MAX]={0x2c28f500,0x35c28f00};           
// unsigned int Fintsto[ANTENNES_MAX*NBPICS_MAX]={0x35c28f00,0x3ae14700};

// SAFRAN 200229 -> 210218 ajout 2 res de fin  // 432.8     433.6       435.0      436.1
unsigned int Fintsta[ANTENNES_MAX*NBPICS_MAX]={0x29FBE770,0x2B020C50,0x2CCCCCD0,0x2E354000};
unsigned int Fintsto[ANTENNES_MAX*NBPICS_MAX]={0x2B020C50,0x2C49BA60,0x2E354000,0x2F5C28F5};
                                               // 433.6    434.6        436.1       437
                                               // 437        451
//unsigned int Fintsta[ANTENNES_MAX*NBPICS_MAX]={0x2F5C0000,0x4147A000};           
//unsigned int Fintsto[ANTENNES_MAX*NBPICS_MAX]={0x33333330,0x451eb000};
                                               // 440        454
 
// Ecole de l'Air                                  430      431         433        434        438.0      439     
//unsigned int Fintsta[ANTENNES_MAX*NBPICS_MAX]={0x26666670,0x27AE1480,0x2A3D70A0,0x2B851EB0,0x30A3D710,0x31EB8520}; 
//unsigned int Fintsto[ANTENNES_MAX*NBPICS_MAX]={0x27AE1480,0x28F5C290,0x2B851EB0,0x2CCCCCD0,0x31EB8520,0x33333330};
//                                                 431      432         434        435        439       440

//                                                430.0      431.2     435.0      436.2      438.0      439.0      440.2      441.4
//unsigned int Fintsta[ANTENNES_MAX*NBPICS_MAX]={0x26666670,0x27EF9DB0,0x2CCCCCD0,0x2E560420,0x30A3D710,0x31EB8520,0x3374BC70,0x34FDF3C0,0x26666670,0x27EF9DB0,0x2CCCCCD0,0x2E560420,0x30A3D710,0x31EB8520,0x3374BC70,0x34FDF3C0}; 
//unsigned int Fintsto[ANTENNES_MAX*NBPICS_MAX]={0x27EF9DB0,0x2978D4FD,0x2E560420,0x30A3D710,0x31EB8520,0x3374BC70,0x34FDF3C0,0x3645A1D0,0x27EF9DB0,0x2978D4FD,0x2E560420,0x30A3D710,0x31EB8520,0x3374BC70,0x34FDF3C0,0x3645A1D0};
//                                                431.2      432.4     436.2      438.0      439.0      440.2      441.4     442.4

//unsigned int Fintsta[ANTENNES_MAX*NBPICS_MAX]={0x2B439600,0x2BC6A800,0x34BC6B00,0x36041900};           
//unsigned int Fintsto[ANTENNES_MAX*NBPICS_MAX]={0x2BC6A800,0x2CCCCD00,0x36041900,0x374BC700};
                                               // 34.2+/-0.8

// G2H8 434.5-442.5 444-448
// unsigned int Fintsta[ANTENNES_MAX*NBPICS_MAX]={0x2c28f500,0x3851eb00};           
// unsigned int Fintsto[ANTENNES_MAX*NBPICS_MAX]={0x36666600,0x3d70a300};


// I1C9 436-444.3 444.3-448
// unsigned int Fintsta[ANTENNES_MAX*NBPICS_MAX]={0x2e147a00,0x38b43900};           
// unsigned int Fintsto[ANTENNES_MAX*NBPICS_MAX]={0x38b43900,0x3d70a300};

// Sergei/SAWHOT : 128 points
//unsigned int Fintsta[ANTENNES_MAX*NBPICS_MAX]={0x26666700,0x2e147b00};
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
//unsigned int Fintsta[ANTENNES_MAX*NBPICS_MAX]={0x44468700,0x44c46700,0x4604d500,0x46762D00,0x47dd2c00,0x484ba600,0x4d6e4400,0x4dd7c500,0x4f4d0500,0x4fba6600,0x512cf800,0x519e4b00}; // schneider HTR01A schneider OK pour 6 capteurs
//unsigned int Fintsto[ANTENNES_MAX*NBPICS_MAX]={0x44c46700,0x4518d500,0x46762D00,0x46f38200,0x484ba600,0x48cd1c00,0x4dd7c500,0x4e5c9700,0x4fba6600,0x503f6000,0x519e4b00,0x5210b600}; // schneider HTR01A schneider OK pour 6 capteurs
#endif
//unsigned int Fintsta[NBPICS_MAX]={0x2a4dd000,0x2b6ae000,0x2cdd3000,0x2dfa4000,0x2f6c8000,0x3089a000,0x31fbe000,0x3318f000,0x348b4000,0x35a85000,0x371aa000,0x3837b000}; // CMR
//                                 433.05     433.92      435.05     435.92     437.05     437.92     439.05     439.92     441.05
//unsigned int Fintsto[NBPICS_MAX]={0x2b6ae000,0x2c87f000,0x2dfa4000,0x2f175000,0x3089a000,0x31a6b500,0x3318f000,0x34361000,0x35a85000,0x36c56000,0x3837b000,0x3954c000}; // CMR

//volatile unsigned int Fintsta[NBPICS_MAX]={0x29990000,0x2b440000}; // hygroX
//				             432.5     433.80  
//volatile unsigned int Fintsto[NBPICS_MAX]={0x2b440000,0x2ccc0000}; // hygroX
//					     433.80    435.00
//volatile unsigned int Fintsta[NBPICS_MAX]={0x2a7f0000,0x2b6ae000}; // default
//				             433.2     433.92 
//volatile unsigned int Fintsto[NBPICS_MAX]={0x2b6ae000,0x2c56d000}; // default
//					     433.92    434.64
#endif

// Seuils min et max de detect. pics (<SEUILMIN=pas de pic, >SEUILMAX=sature)
#ifdef LMD
int SEUILMIN=100;  // dans bete_max, on teste que les voisins soient >SEUILMIN
#else
int SEUILMIN=400;  // dans bete_max, on teste que les voisins soient >SEUILMIN
#endif
int SEUILMAX=4000; // cas de la saturation, < 4095
unsigned int SEUILVAR=10000;// cas convertit_temperature : test sur la variance   AJOUTER 140121

// unsigned char pulse_shape[31]={1,2,3,4,5,6,7,8,9,10,11,12,13,14,15,7,14,17,18,20}; // 5 pas -> puiss 20
// unsigned char pulse_shape[31]={1,2,3,4,5,6,7,8,9,10,11,12,13,14,15,7,12,14,15,16}; // 5 pas -> puiss 16
//const unsigned char pulse_shape[31]={1,1,2,3,4,5,6,7,8,9,10,11,12,13,14,15,17,18}; // 5 pas -> puiss 18
unsigned short pulse_shape[31]={1,2,3,4,5,6,7,8,9,10,11,12,13,14,15,16,17,18,19,20,21,22,23,24,25,26,7,19,25,28,31}; // 5      pas -> puiss 31
// unsigned char pulse_shape[31]={1,2,3,4,5,6,7,8,9,10,11,12,13,14,31,11,1,7,12,15,18,20,22,23,25,26,27,28,29,30,31}; // 15
int EMET=45;      // duree d'emission=45 soit 30 us (ATE)
int NY=PUISS_MAX; // 12; // Pour activer la mise en forme de crenaux
                  // si < PUISS_MAX, alors on a PUISS_MAX-NY marches 
		  //    (pulse_shape) dans le crenau, sinon impulsion rectangle
		  
int A0[ANTENNES_MAX*NBPICS_MAX/2]={-3100,    -2972,    -3599   }; //,    -4085}; // A0 normal *10 
int A1[ANTENNES_MAX*NBPICS_MAX/2]={30639765, 31868012, 39203994}; //, 46645469}; // A1 normal *1E2 
int A2[ANTENNES_MAX*NBPICS_MAX/2]={-24806,   -24428,   -27993  }; //,   -30948}; // A2 normal *1E5 

//#ifdef convertit_temperature // fournit la temperature en 1/10 K

int contrainte0 = (0x72b020); // valeur minimale

#ifdef AD9958
// 0 est un cas particulier pour couper emission
const int puiss9958[32]={1023,880,715,580,480,400,350,307,269,238,208,184,162,142,127,112,99,89,79,71,63,57,51,46,41,36,33,29,25,23,20,0};  // modif 140409: 0 passe de 18 a 0
// P=[12.8 12  11  10  09  08  07  06  05  04  03  02  01  00  -1  -2  -3 -4 -5 -6 -7 -8 -9 -10 -11 -12 -13 -14 -15 -16 -17 -18] dBm
#endif
