jmfriedt/sensor/at25.h

void at25_envoi(unsigned char *, int, unsigned char *, int ,int );
void at25_id(unsigned char*);
void at25_we(void); 
void at25_erase(int );  
void at25_read(int ,unsigned char* , int );
void at25_unlock(int );
void at25_write(int ,unsigned char* ,int );
