jmfriedt/sensor/include/uart.h

/*  450 COMPATIABLE UART CORE REGISTERS */

#define UARTBASE 	(*(volatile unsigned long *) 	0XFFFF0700)
#define COMTX 	 	(*(volatile unsigned long *) 	0XFFFF0700)
#define COMRX 	 	(*(volatile unsigned long *) 	0XFFFF0700)
#define COMDIV0  	(*(volatile unsigned long *) 	0XFFFF0700)
#define COMIEN0  	(*(volatile unsigned long *) 	0XFFFF0704)
#define COMDIV1  	(*(volatile unsigned long *) 	0XFFFF0704)
#define COMIID0  	(*(volatile unsigned long *) 	0XFFFF0708)
#define COMCON0  	(*(volatile unsigned long *) 	0XFFFF070C)
#define COMCON1  	(*(volatile unsigned long *) 	0XFFFF0710)
#define COMSTA0  	(*(volatile unsigned long *) 	0XFFFF0714)
#define COMSTA1  	(*(volatile unsigned long *) 	0XFFFF0718)
#define COMSCR   	(*(volatile unsigned long *) 	0XFFFF071C)
#define COMIEN1  	(*(volatile unsigned long *) 	0XFFFF0720)
#define COMIID1  	(*(volatile unsigned long *) 	0XFFFF0724)
#define COMADR 	 	(*(volatile unsigned long *) 	0XFFFF0728)
#define COMDIV2  	(*(volatile unsigned long *) 	0XFFFF072C)
