jmfriedt/sensor/init_cortex_AD9958.h

#define CS_SET GPIO_SetBits(GPIOA,GPIO_Pin_4)
#define CS_CLR GPIO_ResetBits(GPIOA,GPIO_Pin_4)
#define RESET_SET GPIO_SetBits(GPIOC,GPIO_Pin_0)
#define RESET_CLR GPIO_ResetBits(GPIOC,GPIO_Pin_0)
