jmfriedt/sensor/freemodbus-v1.5.0senseor/demo/ARM/port.h

/*
 * FreeModbus Libary: MSP430 Port
 * Copyright (C) 2006 Christian Walter <wolti@sil.at>
 *
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
 * File: $Id: port.h,v 1.2 2006/11/19 03:36:01 wolti Exp $
 */

#ifndef _PORT_H
#define _PORT_H

/* ----------------------- Platform includes --------------------------------*/

#if defined (__GNUC__)
#include <signal.h>
#endif
#undef CHAR

/* ----------------------- Defines ------------------------------------------*/
#define	INLINE
#define PR_BEGIN_EXTERN_C           extern "C" {
#define	PR_END_EXTERN_C             }

#define ENTER_CRITICAL_SECTION( )   EnterCriticalSection( )
#define EXIT_CRITICAL_SECTION( )    ExitCriticalSection( )
#define assert( expr )

typedef char    BOOL;

typedef unsigned char UCHAR;

typedef char    CHAR;

typedef unsigned short USHORT;
typedef short   SHORT;

typedef unsigned long ULONG;
typedef long    LONG;

#ifndef TRUE
#define TRUE            1
#endif

#ifndef FALSE
#define FALSE           0
#endif

void            EnterCriticalSection( void );
void            ExitCriticalSection( void );


#endif
